im-tomu/fomu-hardware/README.md

# Tomu FPGA

An FPGA in your USB port!

## Hardware

The hardware design files are all in the [hardware/](hardware/) directory.  They were designed using KiCad 5.0.
