im-tomu/fomu-hardware/case/case_0.1.FCStd

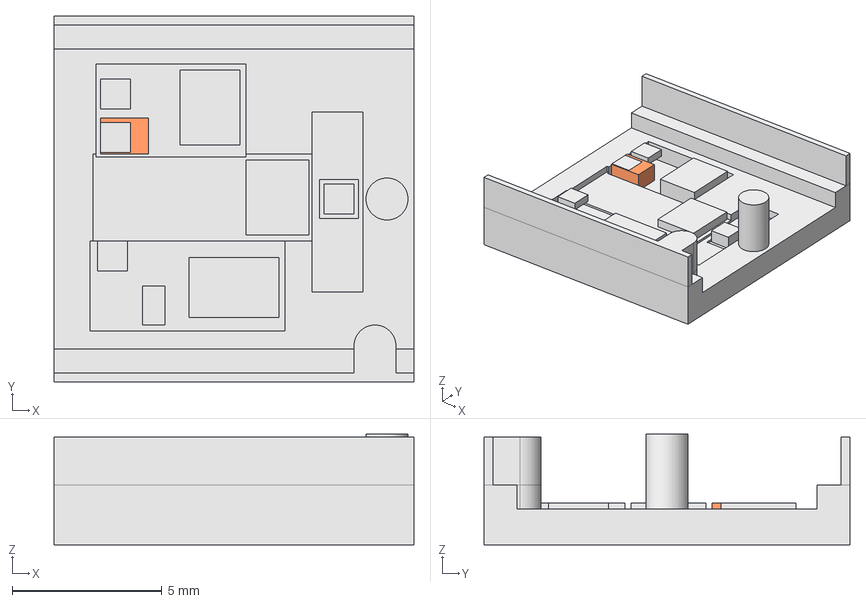
[picture p9: CAD file, 2019-07-12]
case/case_0.1.FCStd
12.0 x 12.2 x 3.70 mm
XTAL
Flash
LED
FlashCap
Hacker MEMS Pad
Regulator 1
Regulator 2
Regulator 3
ICE40
Case
