im-tomu/fomu-hardware/case/case_0.3.FCStd

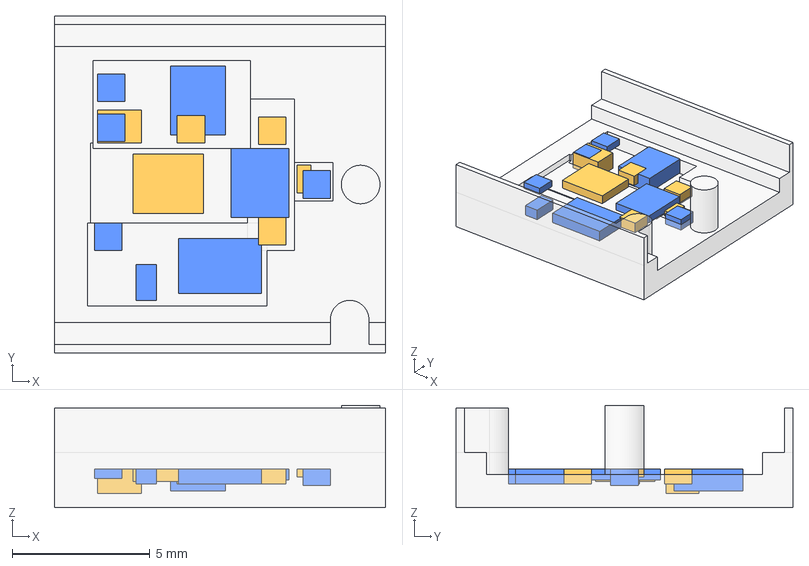
[picture p10: CAD file, 2019-07-12]
case/case_0.3.FCStd
12.0 x 12.2 x 3.70 mm
XTAL
Flash
LED
FlashCap
Hacker MEMS Pad
Regulator 1
Regulator 2
Regulator 3
ICE40
Case
Hacker LED
Hacker ICE40
Hacker Regulator 1
Hacker Regulator 2
Hacker Regulator 3
Hacker Regulator Cap
