im-tomu/fomu-hardware/case/fomu case v5.step

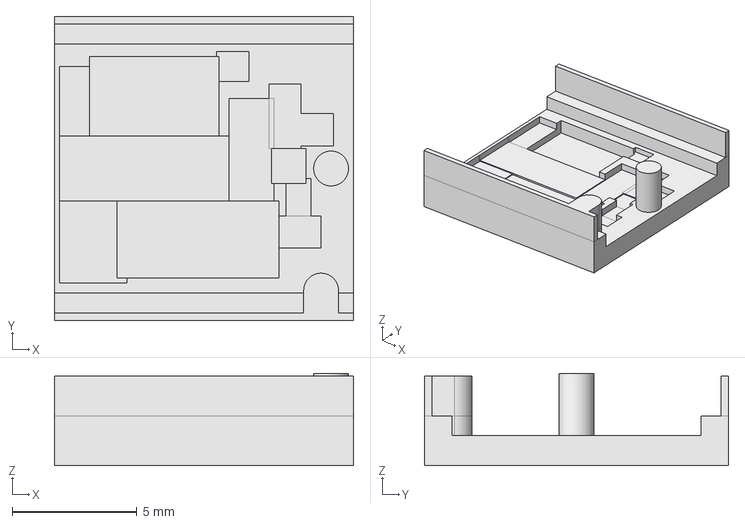
[picture p12: CAD file, 2019-07-12]
case/fomu case v5.step
12.0 x 12.2 x 3.70 mm
