im-tomu/fomu-hardware/case/case_0.2.FCStd

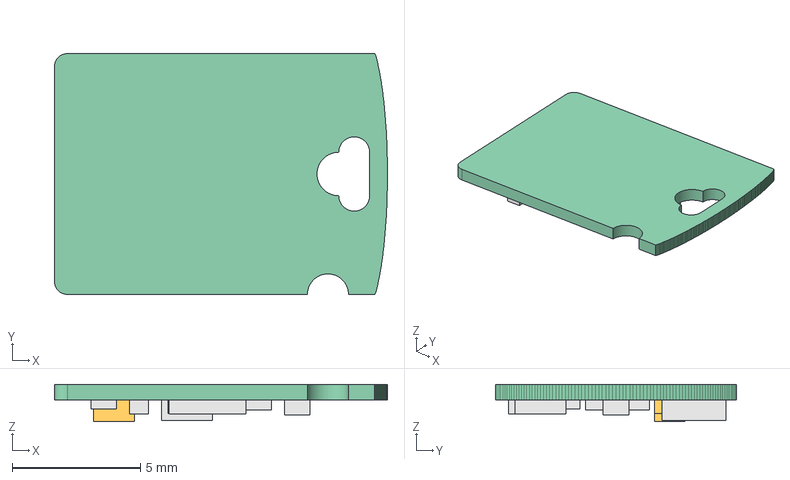
[picture p13: CAD file, 2019-07-12]
case/case_0.2.FCStd
13.0 x 9.40 x 1.45 mm
Pcb
XTAL
Flash
LED
FlashCap
Hacker MEMS Pad
Regulator 1
Regulator 2
Regulator 3
ICE40
Hacker LED
