im-tomu/fomu-hardware/archive/pvt/fomu-pvt-jig.FCStd

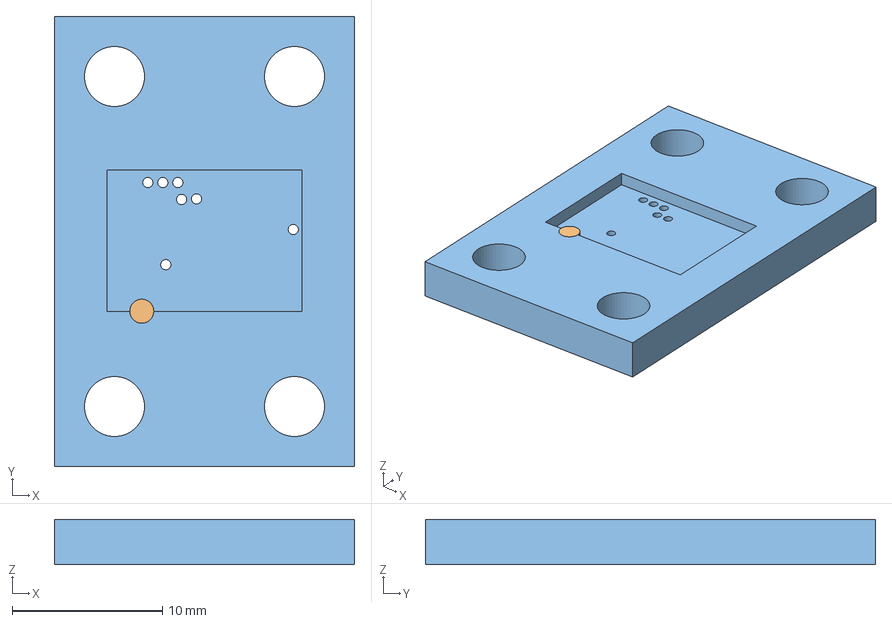
[picture p14: CAD file, 2021-11-25, an earlier design]
archive/pvt/fomu-pvt-jig.FCStd
20.0 x 30.0 x 3.00 mm
