im-tomu/fomu-hardware/(list of files, cad)

Other CAD files:
case/case_0.6.FCStd
case/case_0.5.FCStd
case/case_0.1.stl
case/case_0.2.stl
case/case_0.3.stl
case/case_0.4.stl
case/case_0.5.stl
