im-tomu/fomu-hardware/(threads)

Thread 3 (2019-01-01):

RGB LED Brightness

drandreas, 2019-01-01:
The brightness of red, green, blue is fundamentally different.

To get white the colours have to be mixed:
 - Red @ duty cycle of 1/128
 - Green @ duty cycle of 1/16
 - Blue @  duty cycle of 1/1

The code blow demonstrates the issue.

[rgb.zip](https://github.com/im-tomu/fomu-hardware/files/2719656/rgb.zip)

Edit: According to the documentation, the FPGA has a RGB LED driver with a per color configurable current. What are reasonable values?

drandreas, 2019-01-02:
Looking at the LED's data sheet the current should be <=10mA for continues operation.

I configured the LED driver as follows
 - Red @ 2mA
 - Green @ 2mA
 - Blue @ 10mA

This is clearly the way to go. However it still isn't giving a nice color mixture w/o using pwm in addition.

[rgb_pwm.zip](https://github.com/im-tomu/fomu-hardware/files/2720520/rgb_pwm.zip)

mithro, 2019-01-02:
There isn't really any space for resistors on the board :-P

mithro, 2019-01-02:
Also makes a good starting project for people :-)

drandreas, 2019-01-03:
I’ve came up with another idea.

Blue LEDs have a typical forward voltage thats higher then other colors. Cree states a average forward voltage of 2.9V in the datasheet.

The 2.5V power supply might be simply to low (value taken from schematic)?

drandreas, 2019-01-03:
Note: It could also be that my sample is perticularly bad.

xobs, 2019-01-03:
I haven't noticed this issue on my EVT boards, and those should be electrically identical to the final release.

Can you post an example verilog file to demonstrate what you're seeing? Also, does it change at all if you press on the FPGA part?

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

drandreas, 2019-01-03:
I can counter the issue by having different duty cycles for blue, green and red. I also do only intend to use the RGB LED for diagnostic purposes. So this issue is kind of solved.

However, I wanted to understand why to intensity of the colours is fundamentally different. So I kept digging. The data sheet and hacker version schematic are telling me that the blue LED might be running outside of its spec:
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

This discovery is a correction to my initial perception that RED and GREEN are too bright - BLUE is too dim. Since not much can be done about this I'm closing the issue. Never the less I'm curious why 2.5V instead of 3.3 are used as power source.

xobs, 2019-01-04:
Good find!

The hacker version uses a 2.5V source, and the EVT/DVT/production versions of the board all use 3.3V as the source.

For those PCBs, we'll want to set the constant current sink to ~4 mA for the Red, and ~8 or 10 mA for Green and Blue (running in half mode).

Closed 2019-01-03.

Thread 5 (2019-01-30):

Can flash the fomu with probes, without having the jig

giomasce, 2019-01-30:
Hi,
I managed to flash a fomu Hacker version (v0.0 is mentioned over it) without having a jig: I soldered seven little cables connecting to the Raspberry on a side and having a probe on the other. See the photos. It is not easy to get all the wires connected without the probes snapping away, but it is possible.
The documentation might mention this possibility, as I think that many users could find it easier than printing a jig. Feel free to use my photos, if you want. The ground contact can also be reached from the button pads, which are probably less crowded and easier to reach.
Thanks for this wonderful hacking gadget!
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

mithro, 2019-01-30:
That's pretty impressive! I don't think I could get probes to stay still long enough to successful flash!

mithro, 2019-01-30:
Would be more than happy to merge a pull request showing how to do this method.

giomasce, 2019-01-30:
Here it is! :-)

giomasce, 2019-01-30:
https://github.com/im-tomu/fomu-hardware/pull/6

Closed 2019-02-21.

Thread 7 (2019-05-21):

Remove lock files

mithro, 2019-05-21:
IE -> `reference/.~lock.FPGA-iCE40UP 5k Pinout.xlsx#`

xobs, 2019-05-21:
I'm not seeing that file. I think it was removed on Christmas: https://github.com/im-tomu/fomu-hardware/commit/72816ce2538f67b389f6345c9272df4dd5a1f2e5

mithro, 2019-05-21:
https://github.com/im-tomu/fomu-hardware/tree/evt3/reference

xobs, 2019-05-21:
I've deleted that tag, since that PCB was never built.  EVT3b was built instead, which swapped the pins for PMOD to put I3C on pins 3 and 4.  As part of that tag, the lock file was deleted.

https://github.com/im-tomu/fomu-hardware/tree/evt3b/reference

Closed 2019-05-21.

Thread 8 (2019-06-25):

fomu-hardware git directory/branch structure

ewenmcneill, 2019-06-25:
On 2019-06-25 on #tomu on IRC, @xobs wrote:
> I need to collapse all the branches down to one and make subdirectories. Possibly throwing away history? Or maybe keep the history in the other branches...

The easiest solution is probably to reattach each branch into its own directory in the master branch, creating a new set of git commits that mirror (but aren't the same commits) each branch.

In the past I've done that with [`git-filter-branch`](https://git-scm.com/docs/git-filter-branch)  to rewrite the branches into (or out of) a subdirectory, and then merging that rewritten branch onto master (the two branches likely have no common ancestor at that point, but git will still merge that).

If you can describe the "existing branch" to "new location on single shared branch" transformation that you want to achieve, it should be possible to turn that into an appropriate set of `git-filter-branch` commands and `git-merge` commands to achieve the result *without* throwing away the history.  (In particular "I want to push everything in this branch down one or two directory levels" is one of the easier "rewrite history" transformations...)

xobs, 2019-06-25:
The problem with that is that we would lose tags, as each release of hardware has a separate tag attached to it.  One nice property of the current approach is that you can do "git checkout evt3" and get the state of the repository when that was checked in.

ewenmcneill, 2019-06-25:
@xobs: I'm unclear on what you want here.  Do you (a) want to reassociate the tags with the new commits on the shared branch, (b) keep the old branches, or (c) not rearrange anything because it'll break some other external dependencies.

FWIW, it's perfectly possible to keep the existing branches (and their tags, if you wish), and just stop adding to them.  It's also possible to move the tags to somewhere more relevant in the new structure.  (But it's not possible to have them in both places :-) )   If the branches are re-applied on top of a central branch (`master`?) in a sensible order, the moved tags will even be fairly sensibly ordered.

Anyway my point of creating this ticket is that the mechanical part of rearranging things, retaining history is relatively simple.  Deciding what you want the new structure to look like, down to the level of "we could write a program to transform this" is complicated.

If you've decided you don't want to rearrange anything after all, because it'll break things, feel free to close this issue :-)

Ewen

ewenmcneill, 2019-06-25:
Also FWIW it's literally impossible to change anything in a `git` repository history *without* creating new commits.  By design.  Because it's a chain of hashes.  So you either live with what you have, or you make new commits.  Just saying.

Ewen

xobs, 2019-06-25:
The answer to every problem is "blockchain!"

Users will generally encounter one of three boards: EVT, PVT, and Hacker.  I'd like `master` to have a tree that looks something like:

```
+- gerber
+----- evt1
+----- hacker
+----- pvt1
+- kicad
+----- evt1
+----- hacker
+----- pvt1
+- reference
+--- schematics for boards and PDF files for components
+- case
```

Then the full history will be in the various branches.

This gives something handy to link to, in addition to making it more obvious where things are.

ewenmcneill, 2019-06-25:
What happens with `evt2` and `evt3` in that structure?  And later production versions?  Are they more parallel subdirectories?  Or are they later commits on the "evt1" directory?  Other than that question, and what happens with the tags (moved, to where; left on branch), it looks a fairly simple transformation to me.

Ewen

PS: I was trying to avoid using the "B" word :-)

xobs, 2019-06-25:
In this structure, "evt1", "evt2", etc. are all still in their respective branches, but schematics are pulled out into the `reference` directory as PDF files, and gerber files are pulled to the `gerber` directory as parallel directories.

The alternative would be to just include the zip files that I send to the production house, but that's harder to link to.

ewenmcneill, 2019-06-25:
So https://github.com/im-tomu/fomu-hardware/tree/evt/hardware/pcb becomes `kicad/evt1`?   And there's only `evt1` even though the EVT went through four revisions?  (And it's "evt1" not "evt"?)

And:

https://github.com/im-tomu/fomu-hardware/tree/evt/hardware/releases/evt1
https://github.com/im-tomu/fomu-hardware/tree/evt/hardware/releases/evt2
https://github.com/im-tomu/fomu-hardware/tree/evt/hardware/releases/evt3
https://github.com/im-tomu/fomu-hardware/tree/evt/hardware/releases/evt3b

become:

1.  `gerber/evt1`, `gerber/evt2`, `gerber/evt3`, `gerber/evt3b`; or

2.  `gerber/evt1`, `gerber/evt1`, `gerber/evt1`, `gerber/evt1` commits over the top of each other, with tags to reference which one?

If we can get to the point of a CSV file that has "existing_path,copy_to", then this is automatable, including retaining all history (in new commits) over the transformation.   But I'm still not quite clear on the transformation required.  (And we can leave the old branches just as they are, or remove them, as makes sense for each one.)

Ewen

PS: FTR, because git is a content store (ie, stored by hash of the content), having multiple copies of a given file in multiple locations / multiple branches doesn't take additional space in the git repo itself. They're all effectively symlinks.  (It only potentially takes more space on checkout  of a branch with multiple references to the same file.)

xobs, 2019-06-25:
Option (1) - the releases go into `gerber/evt1`, `gerber/evt2`, `gerber/evt3b`, etc.

With all of the schematic PDFs going either into `reference` or into `gerber` -- I'm not sure which would make more sense.

mithro, 2019-07-06:
Please take a look at https://github.com/mithro/fomu-hardware/tree/master/archive -- this is my proposal for how to structure it....

Closed 2019-07-12.

Thread 13 (2020-01-05):

Hardware Photos

gregdavill, 2020-01-05:
@mithro asked me to take some photos of the Fomu Boards.
Let me know if you would like any other angles/enclosure/LEDs lit etc.

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

mithro, 2020-01-05:
Could you do some in the case?

gregdavill, 2020-01-06:
Like these?

It is a little tricky to get the lighting good/even on both the clear case and the PCB.

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

mithro, 2020-01-06:
These all look awesome!

@gregdavill Can you add the source files in a pull request in https://github.com/im-tomu/fomu-hardware/tree/master/archive/pvt ?

Closed 2020-01-08.

Thread 17 (2020-10-12):

pvt board problems

arblake, 2020-10-12:
If I upload Rob's eforth  it reports that ttyACM0 is available. If I open a terminal program like gtkterm, the port, ttyACM0  dissappears.
If the terminal programming is running before I upload the eforth .
If Rob does the same with the hacker board he has no difficulties. He can remove the board and replace and still all works, whereas I must reload the eforth.
Any suggestions?

xobs, 2020-10-13:
eforth looks like it's overclocking the FPGA, and so it is susceptible to device variations. This means it may not work on your board.

See https://github.com/rob-ng15/Silice-Playground/issues/8

Thread 20 (2022-01-29):

Please provide fomu PVT PCB schematic PDF document.

ramkumarkoppu, 2022-01-29:
Got the fomu board, but link to board schematic https://workshop.fomu.im/en/latest/requirements/_static/reference/schematic-pvt.pdf in the workshop page is not working.

xobs, 2022-01-30:
It looks like the entirety of the `reference` directory doesn't work.

Is there something that needs to be enabled to fix symlinks during build? @mithro

ElectricPotato, 2022-09-05:
Is this schematic accurate? https://www.taricorp.net/2019/fomu-schematic.png
It seems to conflict with the PCF file from APIO's fomu/blinky example

xobs, 2022-09-06:
The workshop has been updated to point the link to the correct PDF.

Closed 2022-09-06.

Thread 21 (2022-05-04):

Hacker Fomu

slagernate, 2022-05-04:
Why not use a fully symmetric layout for the bga pads in the hacker version? This may help stability of the WLCSP.

slagernate, 2022-05-04:
NVM. Misread the gerbers. However, I do wonder if the yield issue is related to the small diameter pads used on the perimeter of the WLCSP.

Closed 2022-05-04.

Thread 22 (2022-08-12):

Question about iCE40 BGA Land Pattern

Cushychicken, 2022-08-12:
Howdy! This isn't an issue per se - I was hoping you could talk a little bit about the footprint you used for the iCE40 part in your design.

The main things I noticed:

- You've staggered the pad diameter between pads on the underside. Best as I can tell it's alternating 0.23mm and 0.2mm diameter pads.
- You're using NSMD (non soldermask defined) pads. We're using 0.25mm pads with no change in mask diameter, so effectively SMD (soldermask defined) pads.

I'm experiencing some issues on a board with the same iCE40 part - out of my initial run of 10 boards, only 1 FPGA actually worked. 😆 I've run myself ragged testing the power, reset, clock sequence, and I'm convinced that's correct. I'm also able to program the device on board, just not run any RTL. My suspicion is that the inner balls of the BGA are not making good pad contact with the board.

Wondering if your land pattern is in response to some manufacturability issues with FOMU - any context you have to offer would be greatly appreciated. Thanks a zillion!

xobs, 2022-08-12:
The difference in diameter size was due to using via-in-pad, which necessitated making some pads bigger. I made the pads symmetrical in order to prevent the part from rotating during reflow -- the theory being it's pulled equally in all directions.

I was asked by my PCB vendor  to increase those pads specifically, and we had very few manufacturability issues once we solved the hard gold issue. You're welcome to use the footprint in your projects!

Cushychicken, 2022-08-12:
I may give that footprint a shot - thanks for the recommendation.

Do you have a link to the hard gold issue you mentioned? I'd like to read up on what you were struggling with there, and see if it has anything in common with our issues.

xobs, 2022-08-12:
It was a problem during actual PCB manufacture. There was an update about this at https://www.crowdsupply.com/sutajio-kosagi/fomu/updates/fomu-production-delay

Cushychicken, 2022-08-12:
I'll read up. Thanks for your help.

Closed 2022-08-12.

Thread 24 (2023-06-13):

Attach the fomu board on WSL 2 or Virtualbox virtual machine

FelipeWcosta, 2023-06-13:
I am trying use the fomu PVT board version in a virtual machine. When I put it in USB port the Windows OS recognize it correctly, as you can see below:
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

But, when I try to attach the board to virtual machine that occur:
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

The warning is: **Unknown USB Device (Device Descriptor Request Failed)**

This erro appears in both VirtualBox and WSL 2. I updated the drivers using Zadig 2.8 and for attach the board on WSL 2 VM's I am using usbipd 3.0.0.

xobs, 2023-06-14:
There were many improvements to the reset logic in the most recent version of the firmware. Older versions, such as 1.9.1, didn't properly handle the USB reset condition and behaved like that.

Would you mind updating to 2.0.3 and see if that doesn't improve things?

FelipeWcosta, 2023-06-14:
Is there a specific command to do this? If yes, Which is it?

FelipeWcosta, 2023-06-14:
Please, disregard my last comment. Update the firmware fixed the issue!

I'm closing this issue.

Closed 2023-06-14.

Thread 25 (2023-06-20):

Kosagi FOMU pvt board acess by `/dev/tty`

FelipeWcosta, 2023-06-20:
Hello everyone!

I am working with `litex/CFU-Playground` tools and to flash a CPU like `Vexriscv` I need to acess the board by `/dev/ttyUSB0`, `/dev/ttyUSB1` or `/dev/ttyACM0` if possible.

When I run `lsusb` I can see that device is connected:
```
Bus 002 Device 001: ID 1d6b:0003 Linux Foundation 3.0 root hub
Bus 001 Device 004: ID 1209:5bf0 Generic Fomu PVT running DFU Bootloader v2.0.4
Bus 001 Device 001: ID 1d6b:0002 Linux Foundation 2.0 root hub
```
But do not exist none file like `/dev/ttyUSB0` or `/dev/ttyUSB1` then a tryed to do something like this to have acess adding the rule at `/etc/udev/rules.d/99-kosagi-fomu-pvt.rules`:
```
SUBSYSTEM=="tty", ATTRS{idVendor}=="1209", ATTRS{idProduct}=="5bf0", MODE="0664", SYMLINK+="ttyUSB0"
```

But still does not worked, I am using `Ubuntu-22.04` by `WSL 2`.

xobs, 2023-06-20:
The cpu, by default doesn't expose a serial port. It only does DFU, so you will need to upload some temporary firmware to get the functionality you need.

Wishbone-tool knows how to speak a special protocol that allows you to debug the device, though I'm not sure if it will work via wsl2. You might need to run wishbone-tool under Windows instead.

FelipeWcosta, 2023-06-21:
I made a setup  for a `wishbone-tool`, I even can flash some values at memory to controller the RGB led, like you can see,  but no more than this. Maybe, make `Ubuntu` my main OS will be more sense.
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

Closed 2023-07-09.

Thread 26 (2025-09-01):

Is it possible to use the SPI testpoints for JTAG?

snoop911, 2025-09-01:
I understand the Ice40 doesn't have a native JTAG, but since a soft-jtag is often instantiated for Lattice Reveal software, I imagine it could be done via LiteX?   Perhaps something like:

python3 -m litex_boards.targets.fomu \
  --board=fomu \
  --cpu-type=vexriscv \
  --cpu-variant=standard+debug \
  --uart-name=crossover \
  --with-jtagbone
  --csr-csv=csr.csv \
  --build

I've tried but haven't had any luck getting SpinalHDL OpenOCD (0.11.0+dev-04036-ga0220ad30) to recognize the VexRiscV:
  dtmcontrol is 0 or JTAG scan chain interrogation failed: all ones.

 ./src/openocd -c "adapter driver ftdi"
-c "ftdi vid_pid 0x0403 0x6010"
-c "ftdi channel 0"
-c "adapter speed 1000"
-c "transport select jtag"
-c 'jtag newtap lx cpu -irlen 4'
-c 'target create lx.cpu0 vexriscv -endian little -chain-position lx.cpu -dbgbase 0xF00F0000'
-c 'vexriscv cpuConfigFile cpu0.yaml'
-c 'init'
-c 'reset halt'

xobs, 2025-09-02:
You certainly could repurpose the JTAG pins that way, but doing so requires additional hardware in the form of:

1. A test jig to hit the pins
2. A hardware debugger to speak JTAG

neither of which are very common in beginner circles. Additionally, if your openocd is looking for "dmcontrol" then that's looking for a standard risc-v debug spec implementation, which isn't present on Fomu. Perhaps a newer version of the vexriscv cpu would have it, yes, but that would require more work.

snoop911, 2025-09-07:
Yes, that's the goal.  Thru the normal USB/SPI interface I want to program a bitstream design that instantiates a JTAG controller on the 4 user I/O pins.

I tacked wires on the I/Os and connected it to an OpenOcd supported jtag chip (FTDI F2232H).

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

I've checked the connection between the Fomu and the JTAG adapter, and everything is going where it should yet SpinalHDL OpenOCD does not see the VexRiscV.

```
Error: JTAG scan chain interrogation failed: all ones
Info : JTAG tap: riscv.tap tap/device found: 0x41111043 (mfg: 0x021 (Lattice Semi.), part: 0x1111, v
er: 0x4)
Error: dtmcontrol is 0. Check JTAG connectivity/board power.
Warn : target riscv.cpu examination failed
Error: Trying to use configured scan chain anyway...
Error: lx.cpu: IR capture error; saw 0x0f not 0x01
Error: ERROR: Error while reading from socket: No error
Error: Can't communicate with the CPU
Warn : target lx.cpu0 examination failed
Warn : There are no enabled taps. AUTO PROBING MIGHT NOT WORK!!
Warn : Bypassing JTAG setup events due to errors
Error: !!!
TARGET: lx.cpu0 - Not halted
```

I know by default the fomu uses the vexriscv minimal variant, but is there any reason standard+debug can't work?  Should I try instantiating a different Cpu.. NEORV32?  I'm not too familiar with LiteX or openocd so I'm sure the issue is between the keyboard and the chair... but I've hit a wall trying to figure it out what!
