im-tomu/fomu-hardware/hacker/releases/v0.0-19-g154fecc/schematic.pdf

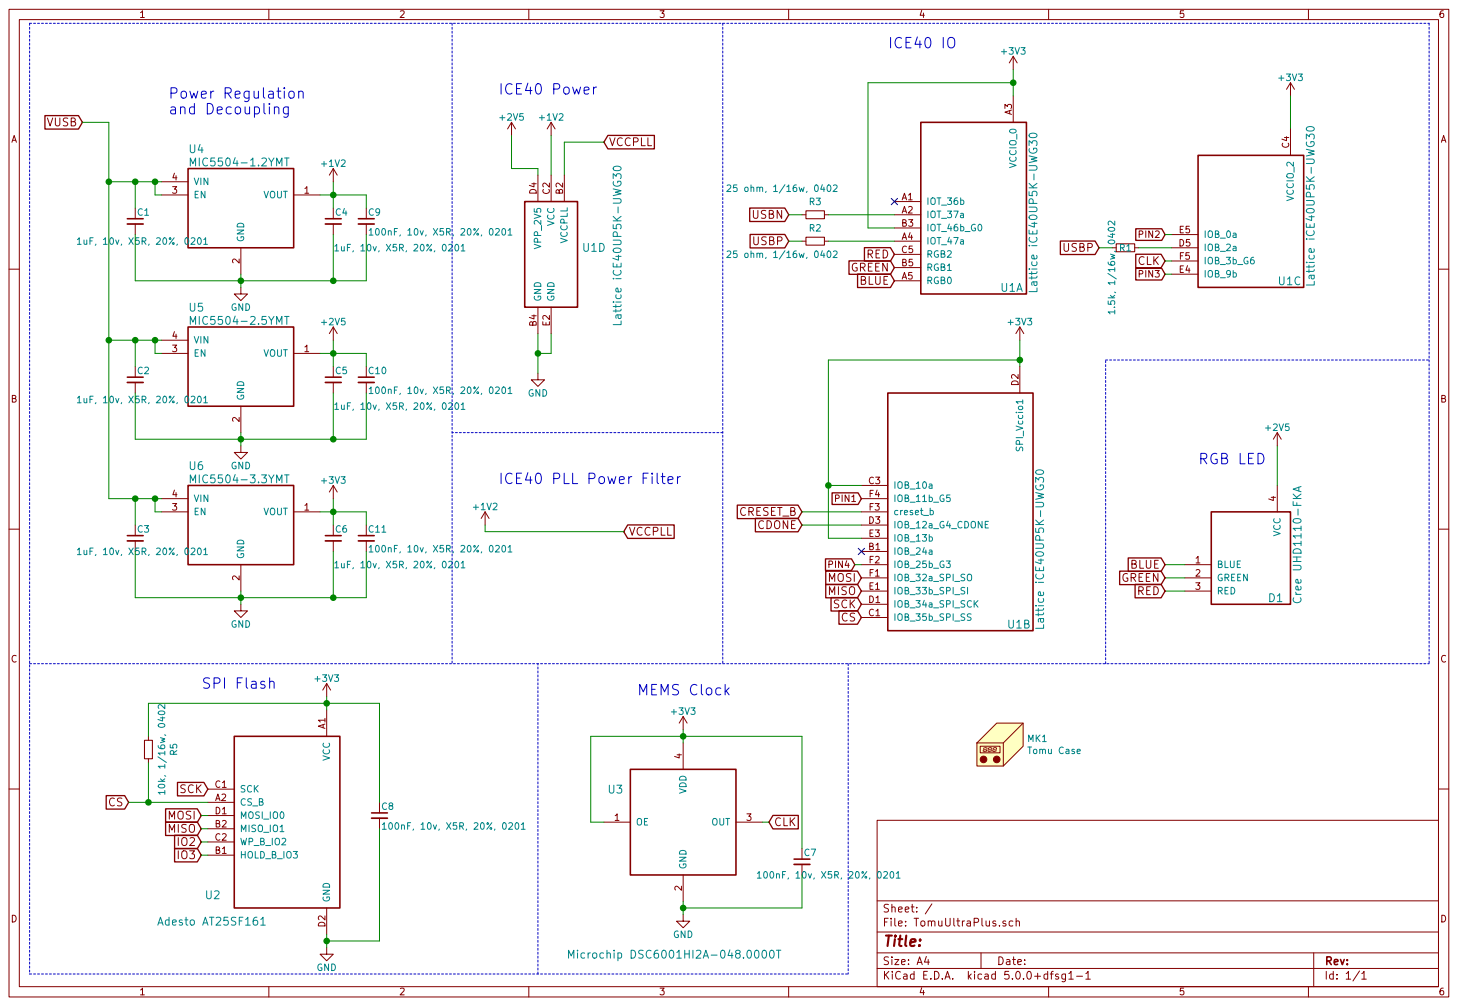
[picture p15: page 1]

4 BLUE 1 GREEN 2 RED 3 D1 Cree UHD1110-FKA VDD

MEMS Clock SPI Flash
