im-tomu/fomu-hardware/archive/dvt/releases/dvt1c/gerber/tomu-fpga-schematic.pdf

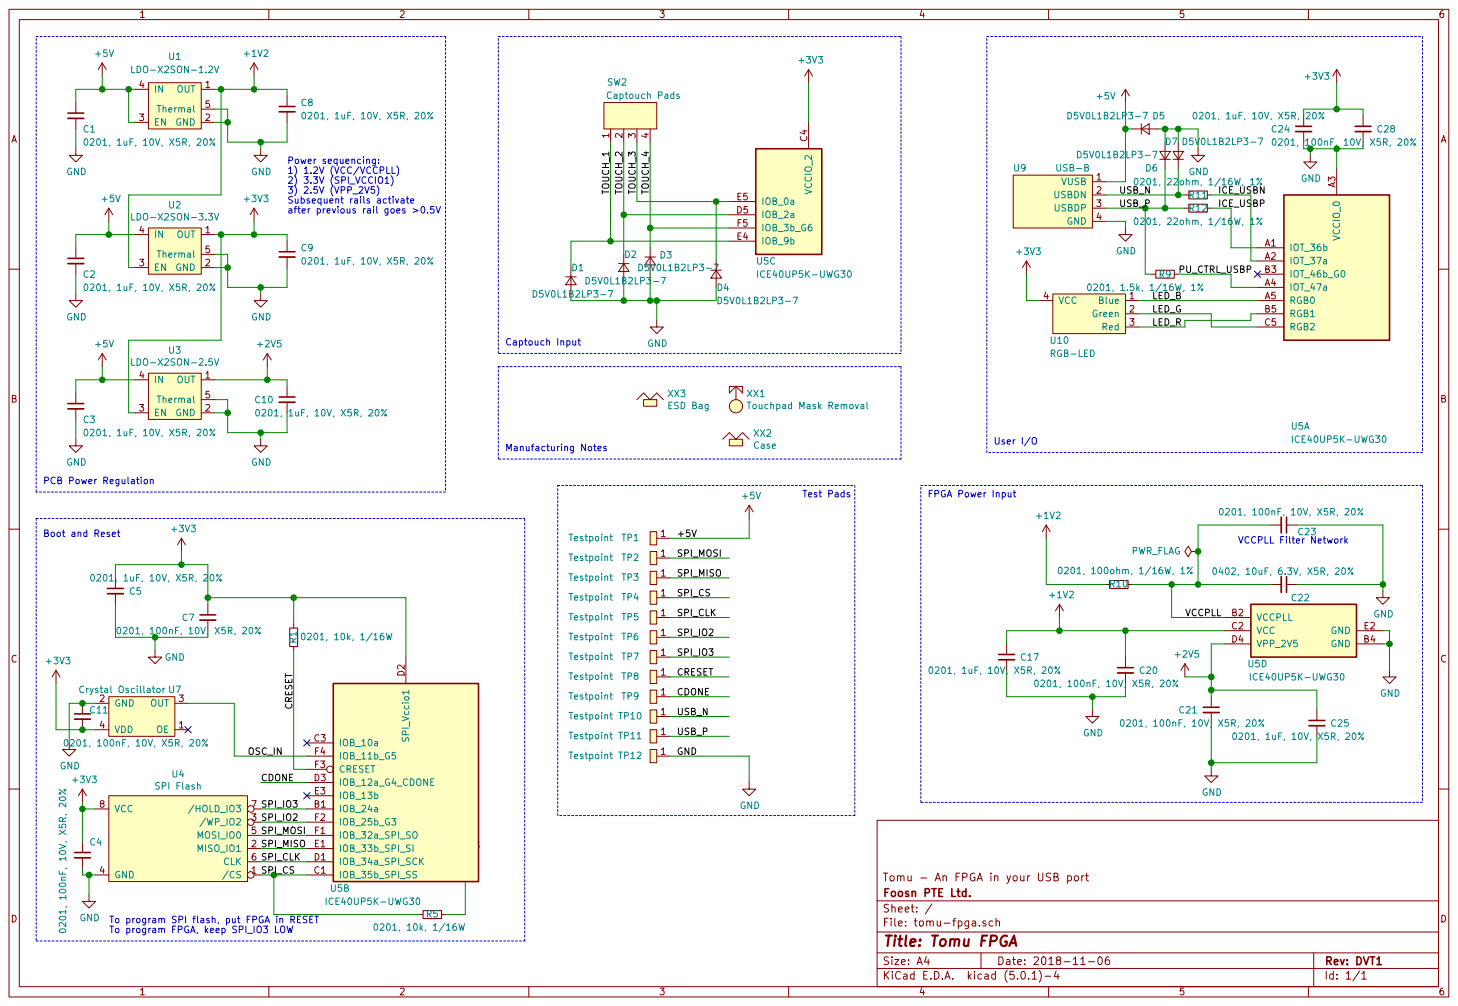
[picture p16: page 1]

File: tomu-fpga.sch Sheet: / Foosn PTE Ltd. Tomu - An FPGA in your USB port GND GND GND

ICE40UP5K-UWG30 To program SPI flash, put FPGA in RESET

Id: 1/1 Title: Tomu FPGA

To program FPGA, keep SPI_IO3 LOW
