im-tomu/fomu-hardware/archive/pvt/releases/pvt1/gerber/tomu-fpga-schematic.pdf

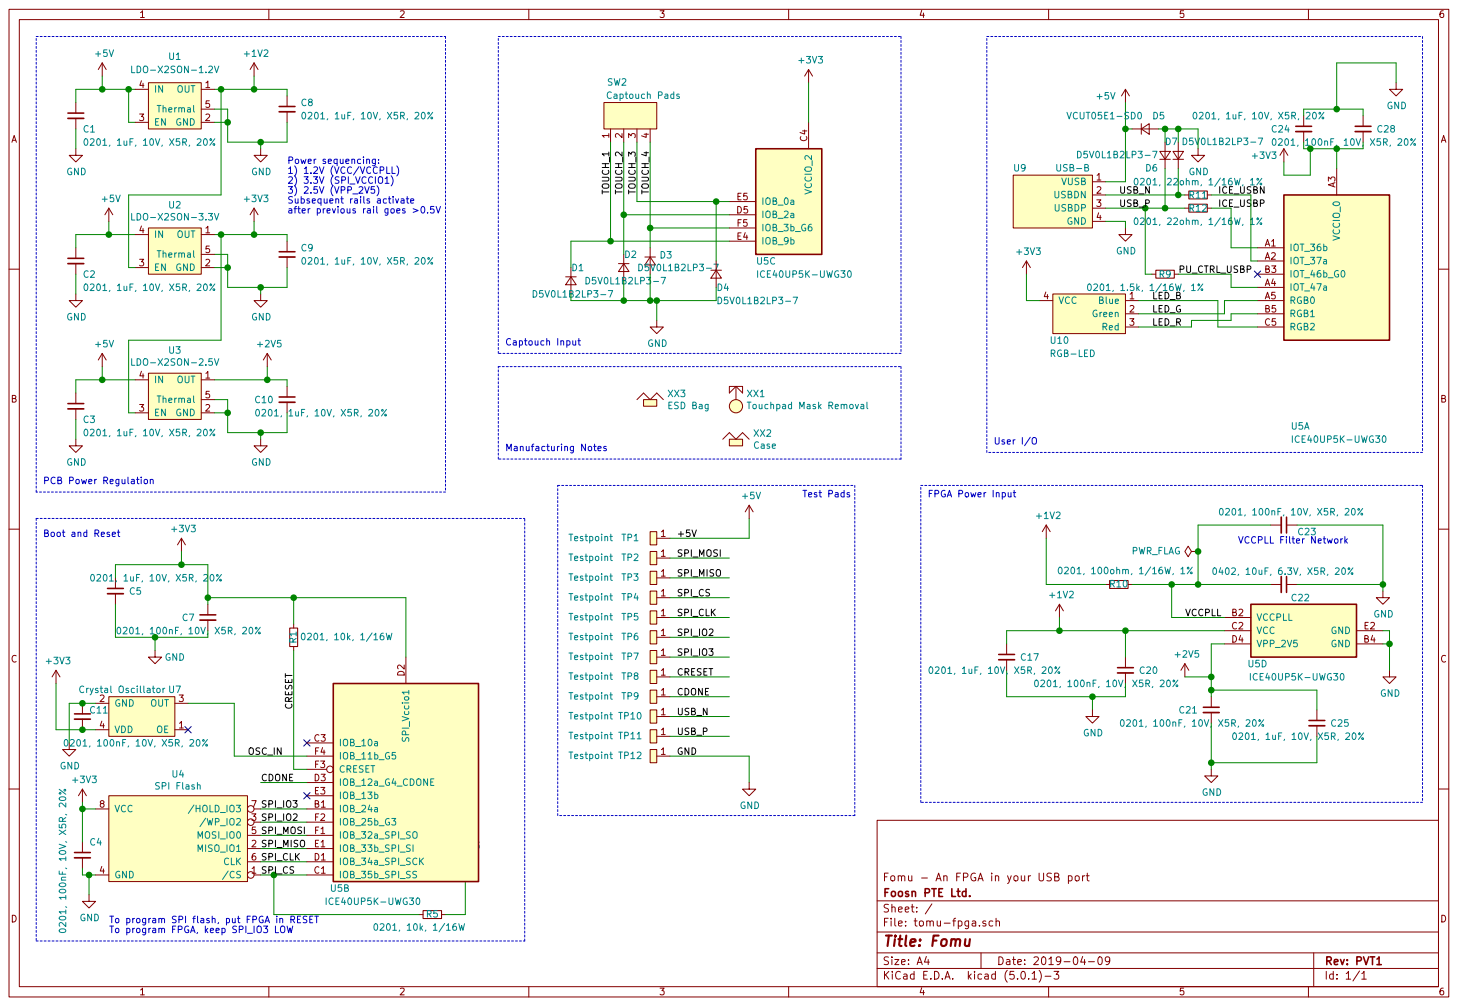
[picture p17: page 1]

File: tomu-fpga.sch Sheet: / Foosn PTE Ltd. Fomu - An FPGA in your USB port GND GND GND

IOB_2a D5

IOB_9b E4

ICE40UP5K-UWG30 To program SPI flash, put FPGA in RESET

To program FPGA, keep SPI_IO3 LOW
