im-tomu/fomu-hardware/archive/evt/releases/evt1/tomu-fpga-evt1.pdf

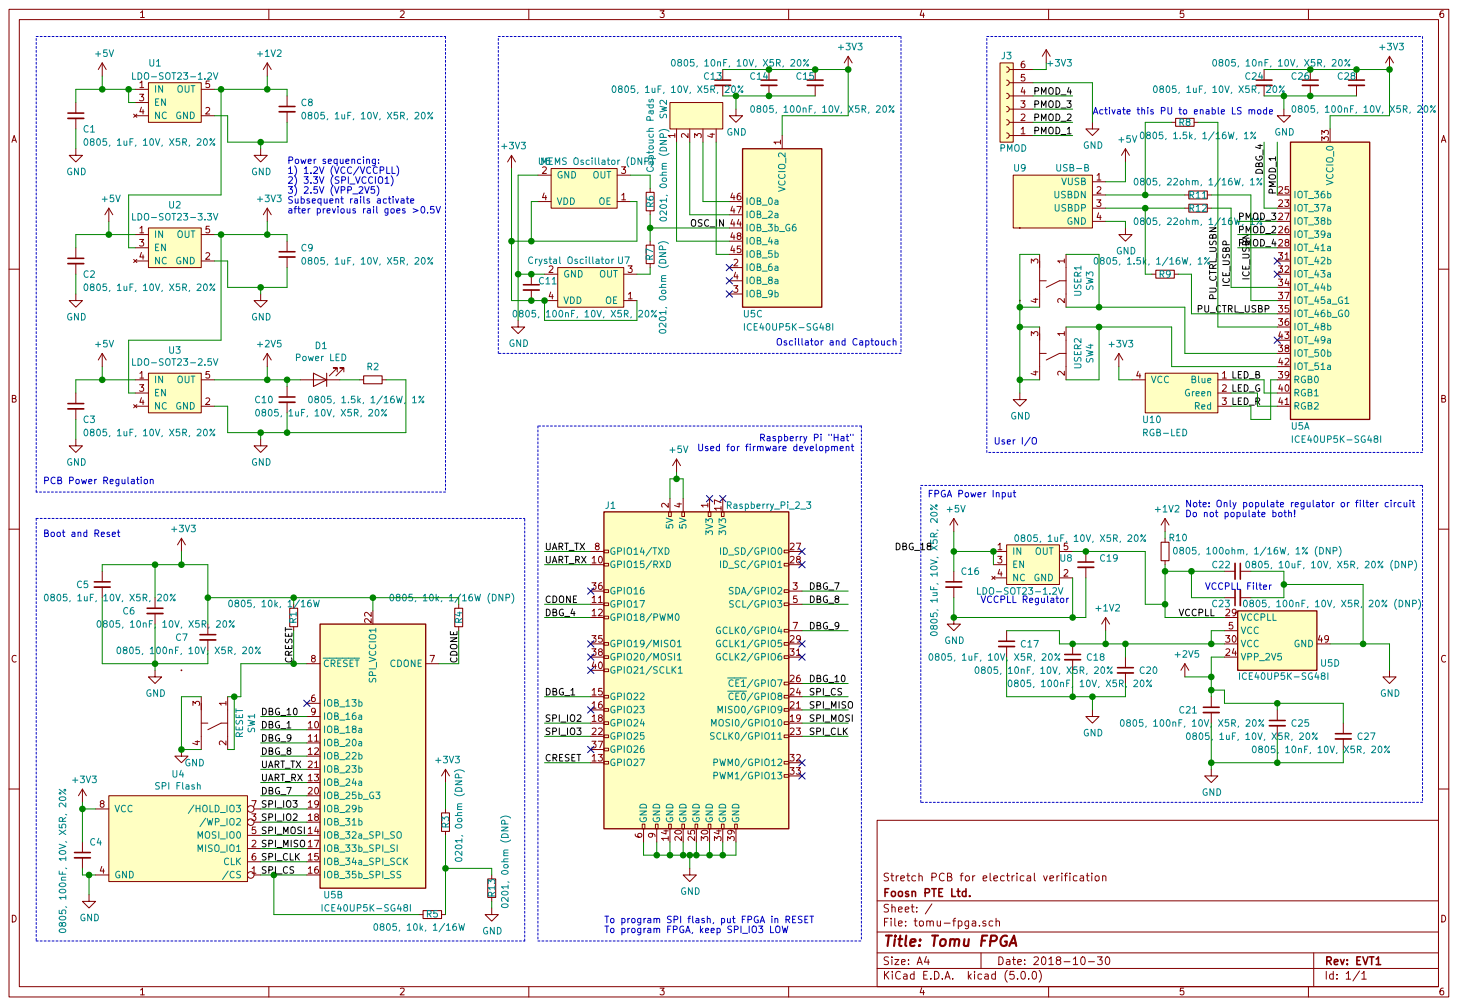
[picture p18: page 1]

Activate this PU to enable LS mode

Used for firmware development 1 2

Note: Only populate regulator or filter circuit

File: tomu-fpga.sch Sheet: / Foosn PTE Ltd. Stretch PCB for electrical verification

Id: 1/1 Title: Tomu FPGA

To program FPGA, keep SPI_IO3 LOW
