im-tomu/fomu-hardware/archive/evt/releases/evt2/gerber/tomu-fpga-evt2.pdf

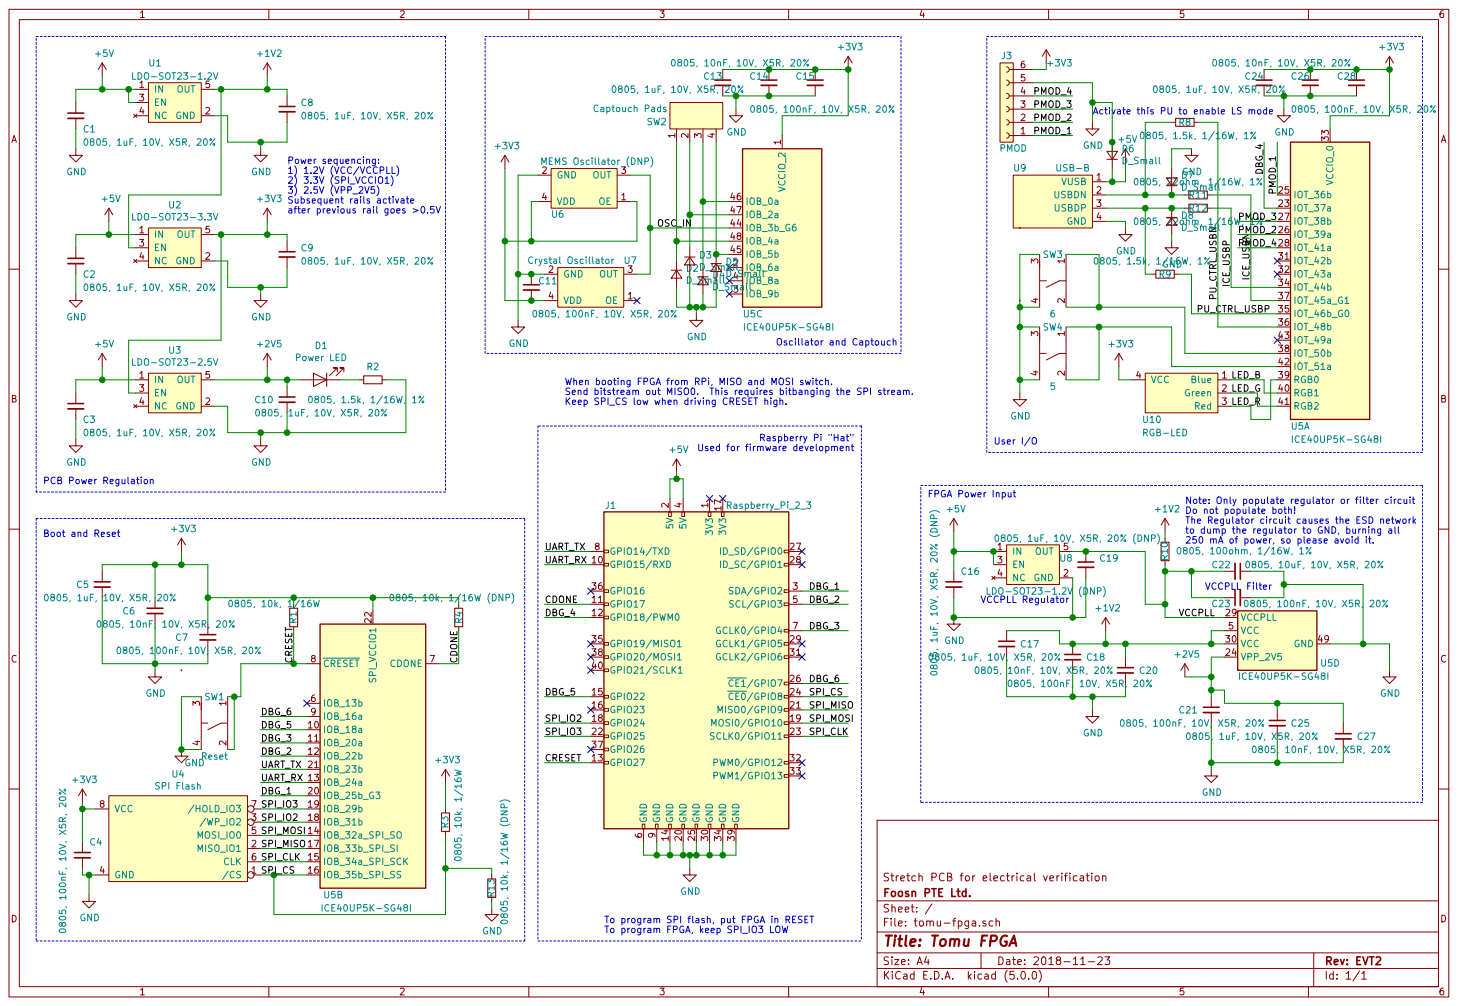
[picture p19: page 1]

Activate this PU to enable LS mode

IOB_3b_G6 44

Keep SPI_CS low when driving CRESET high. D2D_Small D3D_Small D4D_Small D5D_Small GND

IOB_5b 45

When booting FPGA from RPi, MISO and MOSI switch.
Send bitstream out MISO0. This requires bitbanging the SPI stream.

Used for firmware development 1 2

Note: Only populate regulator or filter circuit
Do not populate both!
The Regulator circuit causes the ESD network
to dump the regulator to GND, burning all

File: tomu-fpga.sch Sheet: / Foosn PTE Ltd. Stretch PCB for electrical verification

Id: 1/1 Title: Tomu FPGA

To program FPGA, keep SPI_IO3 LOW
