im-tomu/fomu-hardware/archive/dvt/releases/dvt1c/gerber/tomu-fpga_assy.pdf

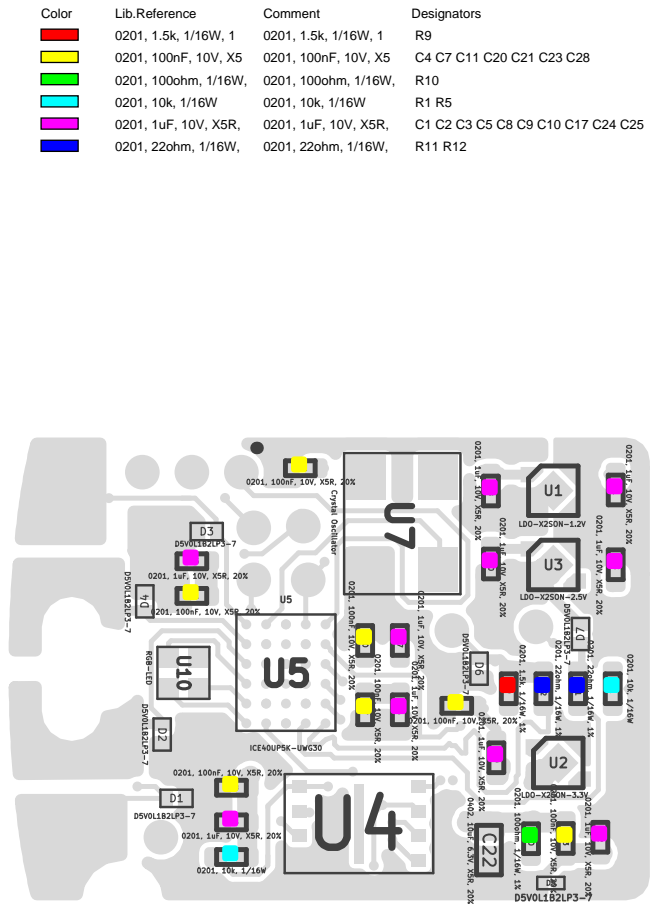
[picture p20: page 1]

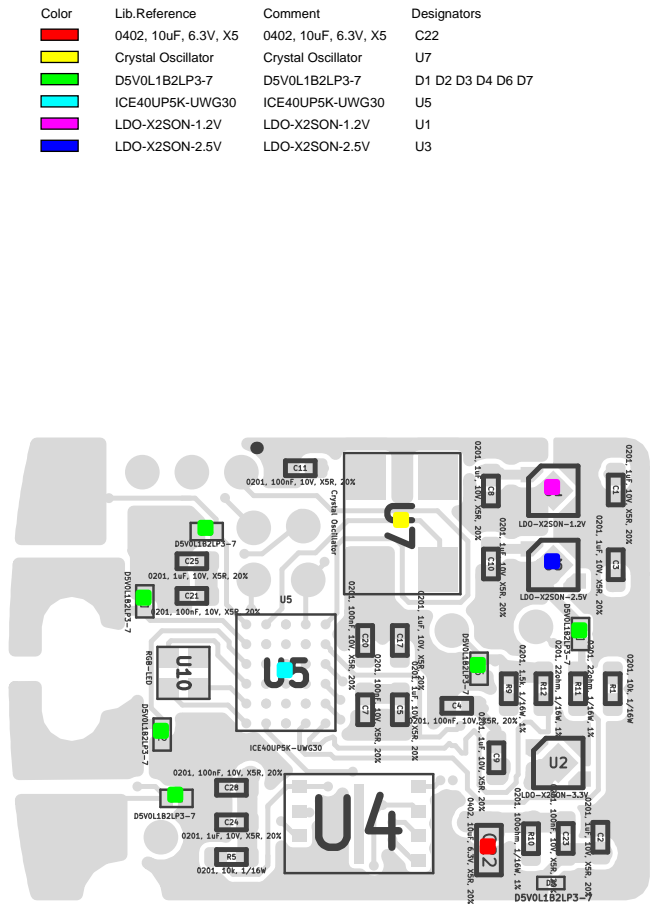
[picture p21: page 2]

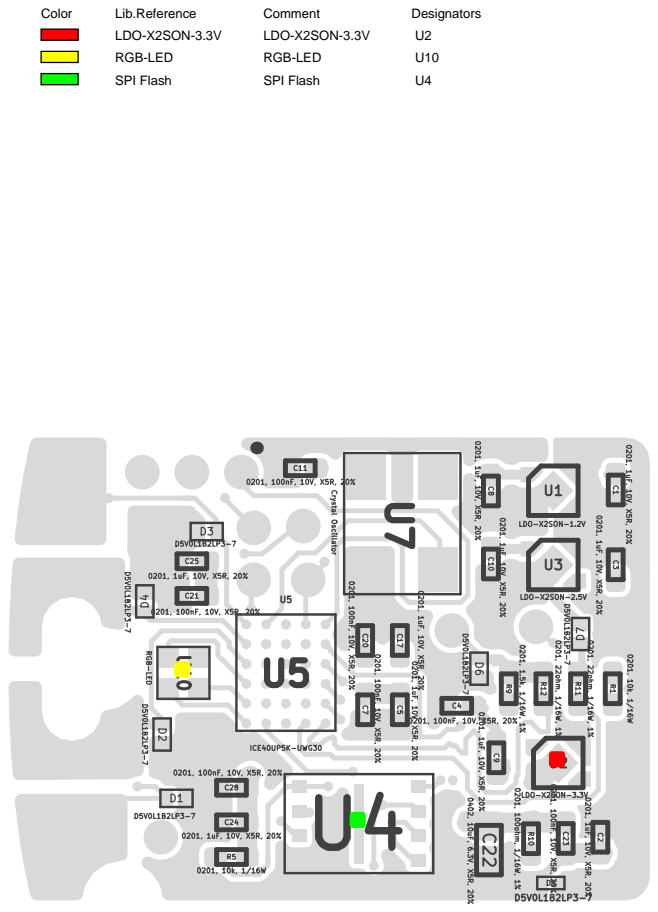
[picture p22: page 3]
Color; Lib.Reference; Comment; Designators; LDO-X2SON-3.3V; RGB-LED; SPI Flash
