im-tomu/fomu-hardware/archive/dvt/releases/dvt1e/gerber/tomu-fpga-dvt1e-assy.pdf

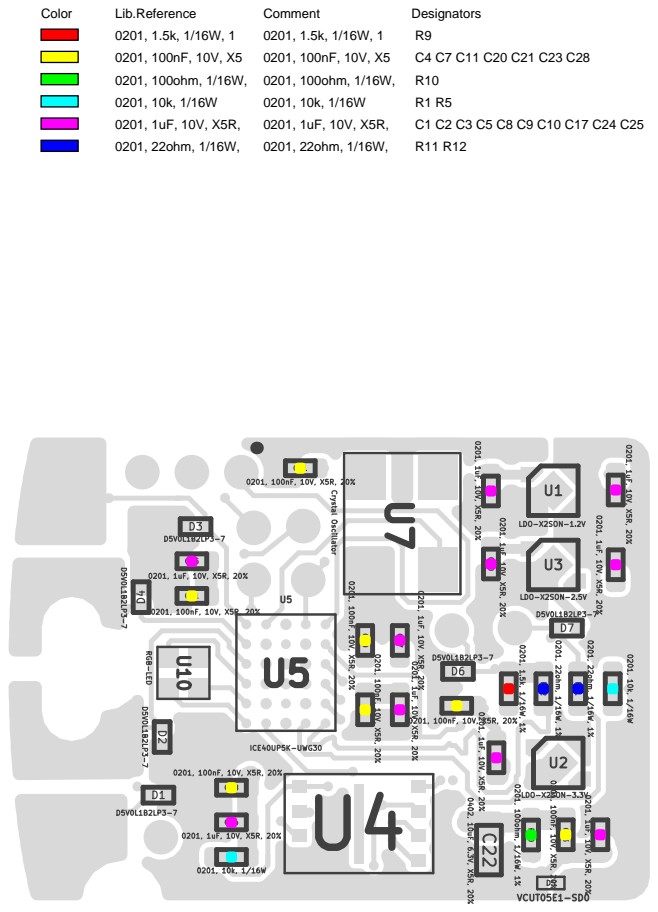
[picture p23: page 1]

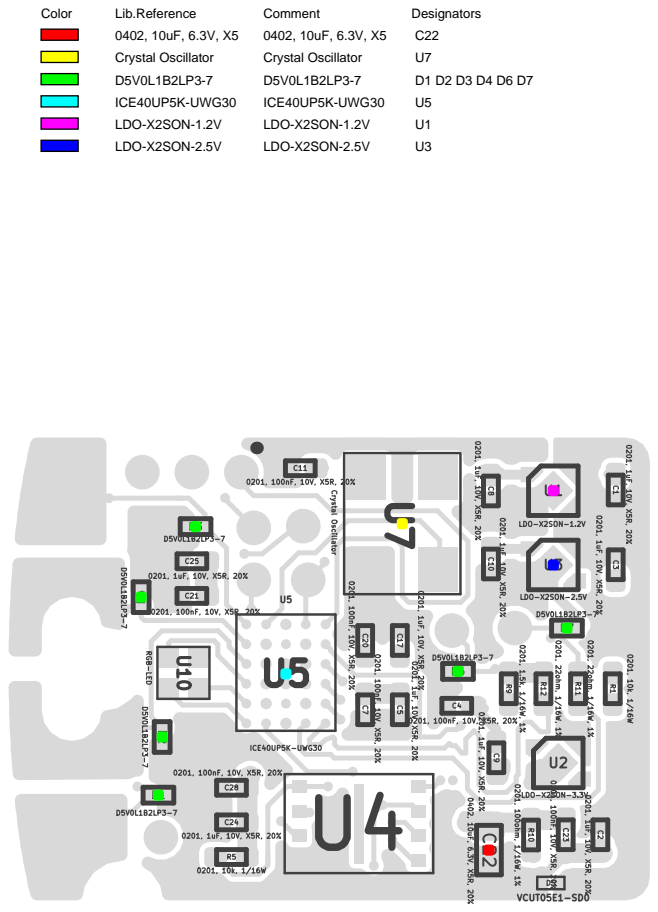
[picture p24: page 2]

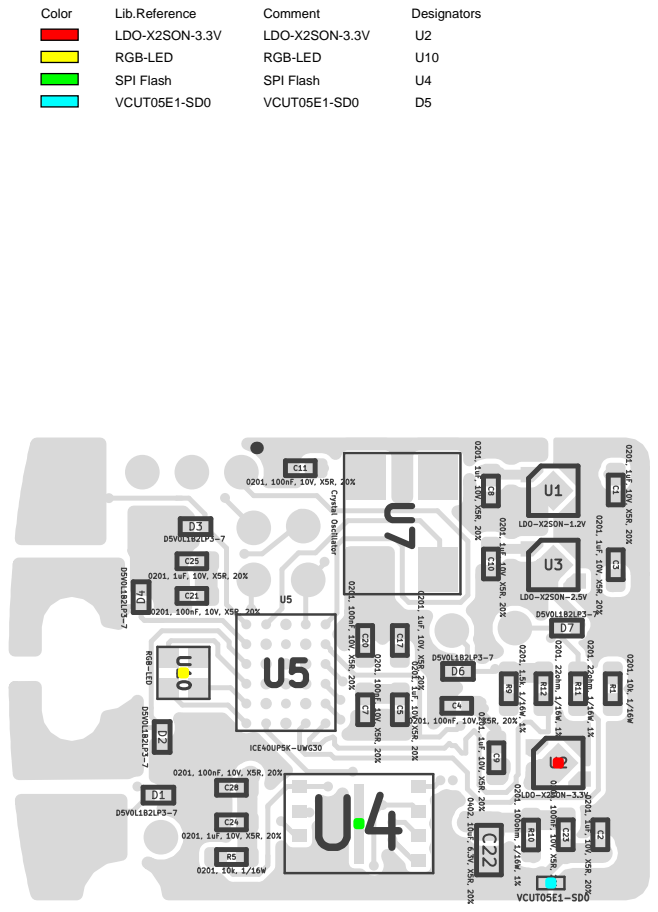
[picture p25: page 3]
Color; Lib.Reference; Comment; Designators; LDO-X2SON-3.3V; RGB-LED; SPI Flash; VCUT05E1-SD0
