im-tomu/fomu-hardware/archive/dvt/releases/dvt2a/gerber/tomu-fpga_assy.pdf

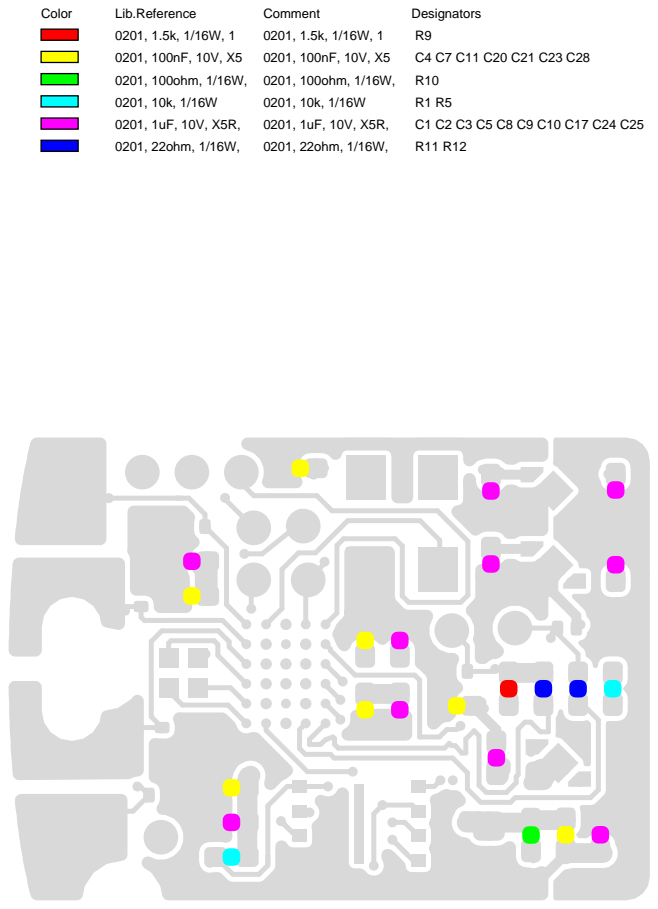
[picture p26: page 1]

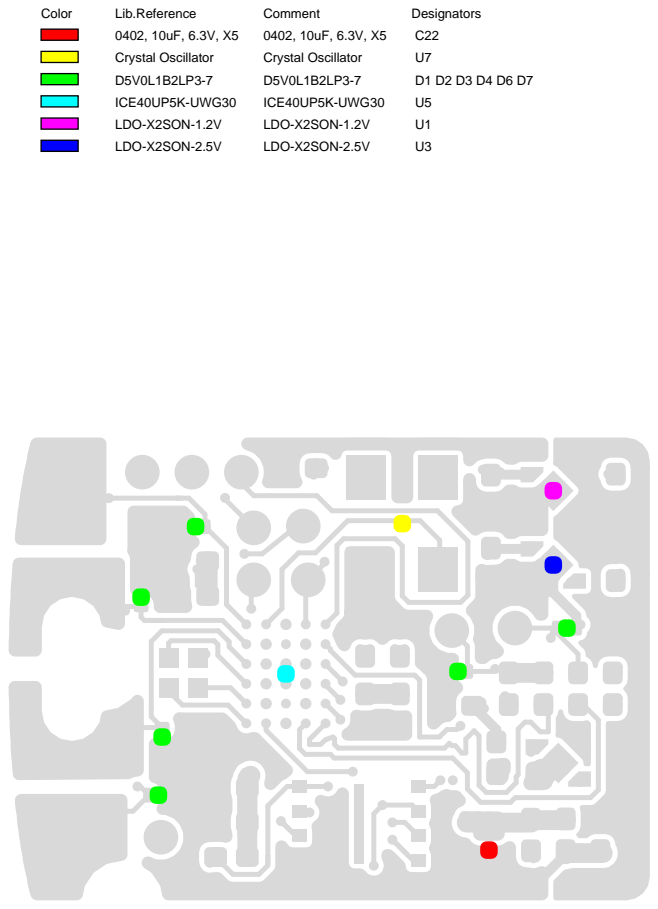
[picture p27: page 2]

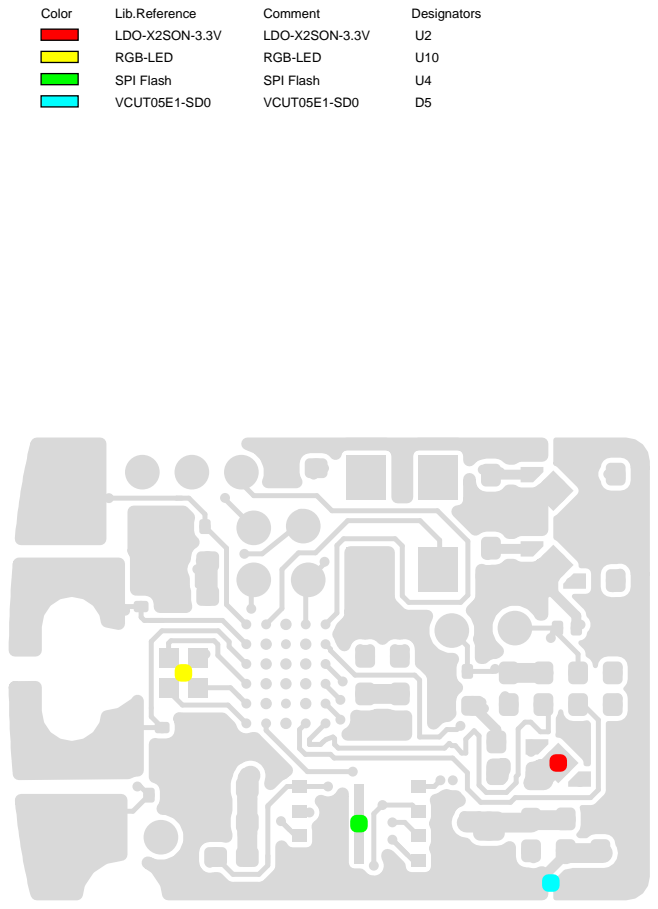
[picture p28: page 3]
Color; Lib.Reference; Comment; Designators; LDO-X2SON-3.3V; RGB-LED; SPI Flash; VCUT05E1-SD0
