im-tomu/fomu-hardware/archive/evt/releases/evt3b/gerber/tomu-fpga_assy.pdf

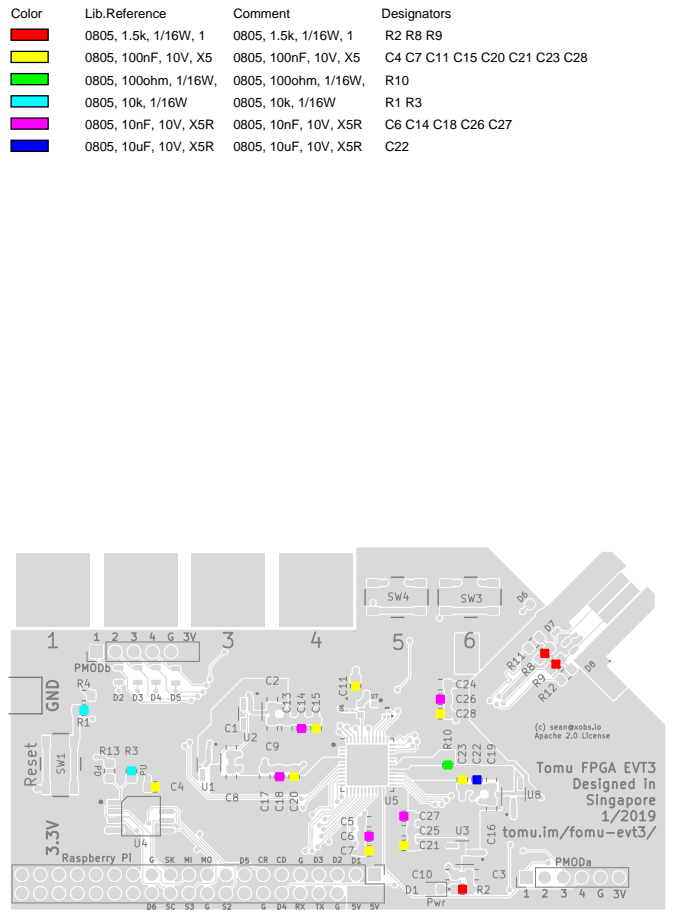
[picture p33: page 1]

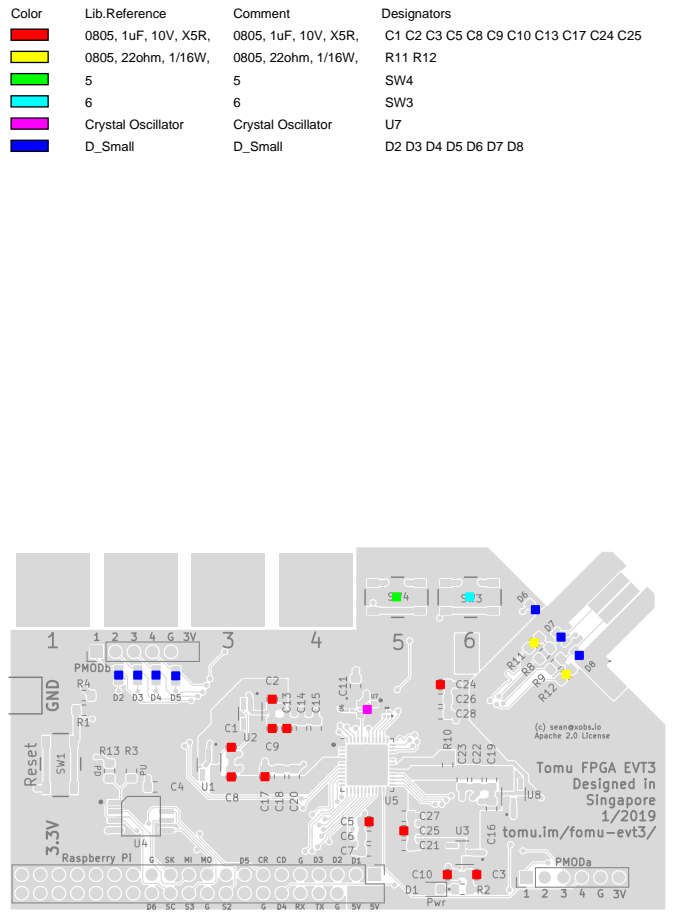
[picture p34: page 2]

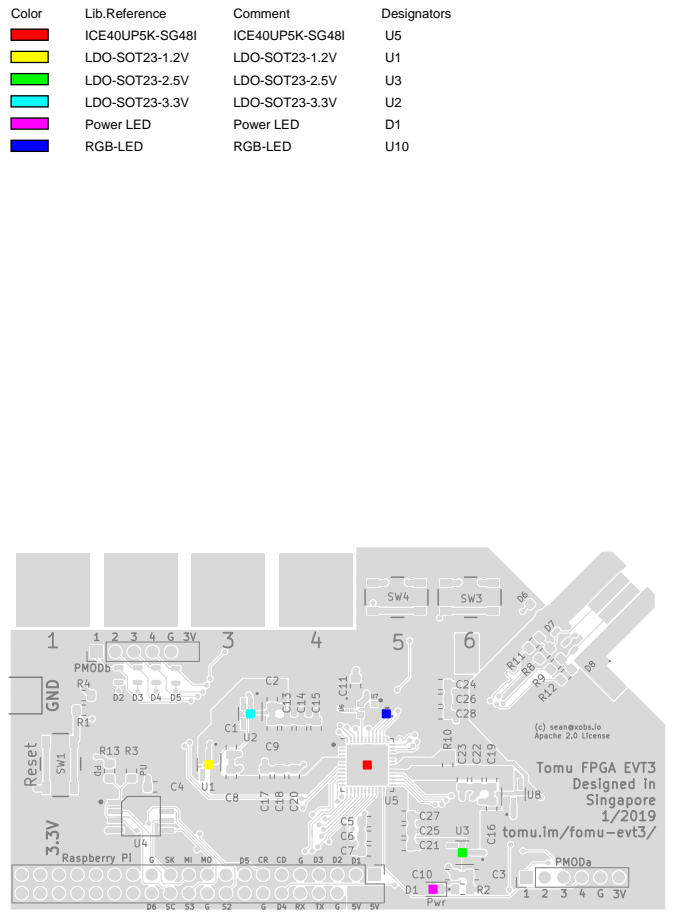
[picture p35: page 3]
Color; Lib.Reference; Comment; Designators; ICE40UP5K-SG48I; LDO-SOT23-1.2V; LDO-SOT23-2.5V; LDO-SOT23-3.3V; Power LED; RGB-LED

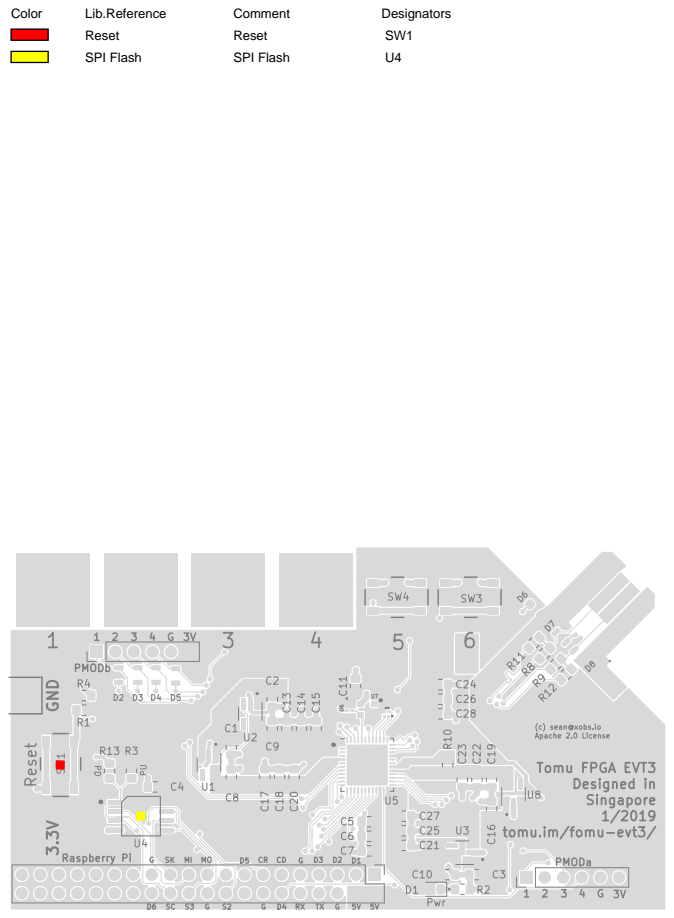
[picture p36: page 4]
Color; Lib.Reference; Comment; Designators; Reset; SPI Flash
