im-tomu/fomu-hardware/archive/pvt/releases/pvt1/tomu-fpga-pvt1.pdf

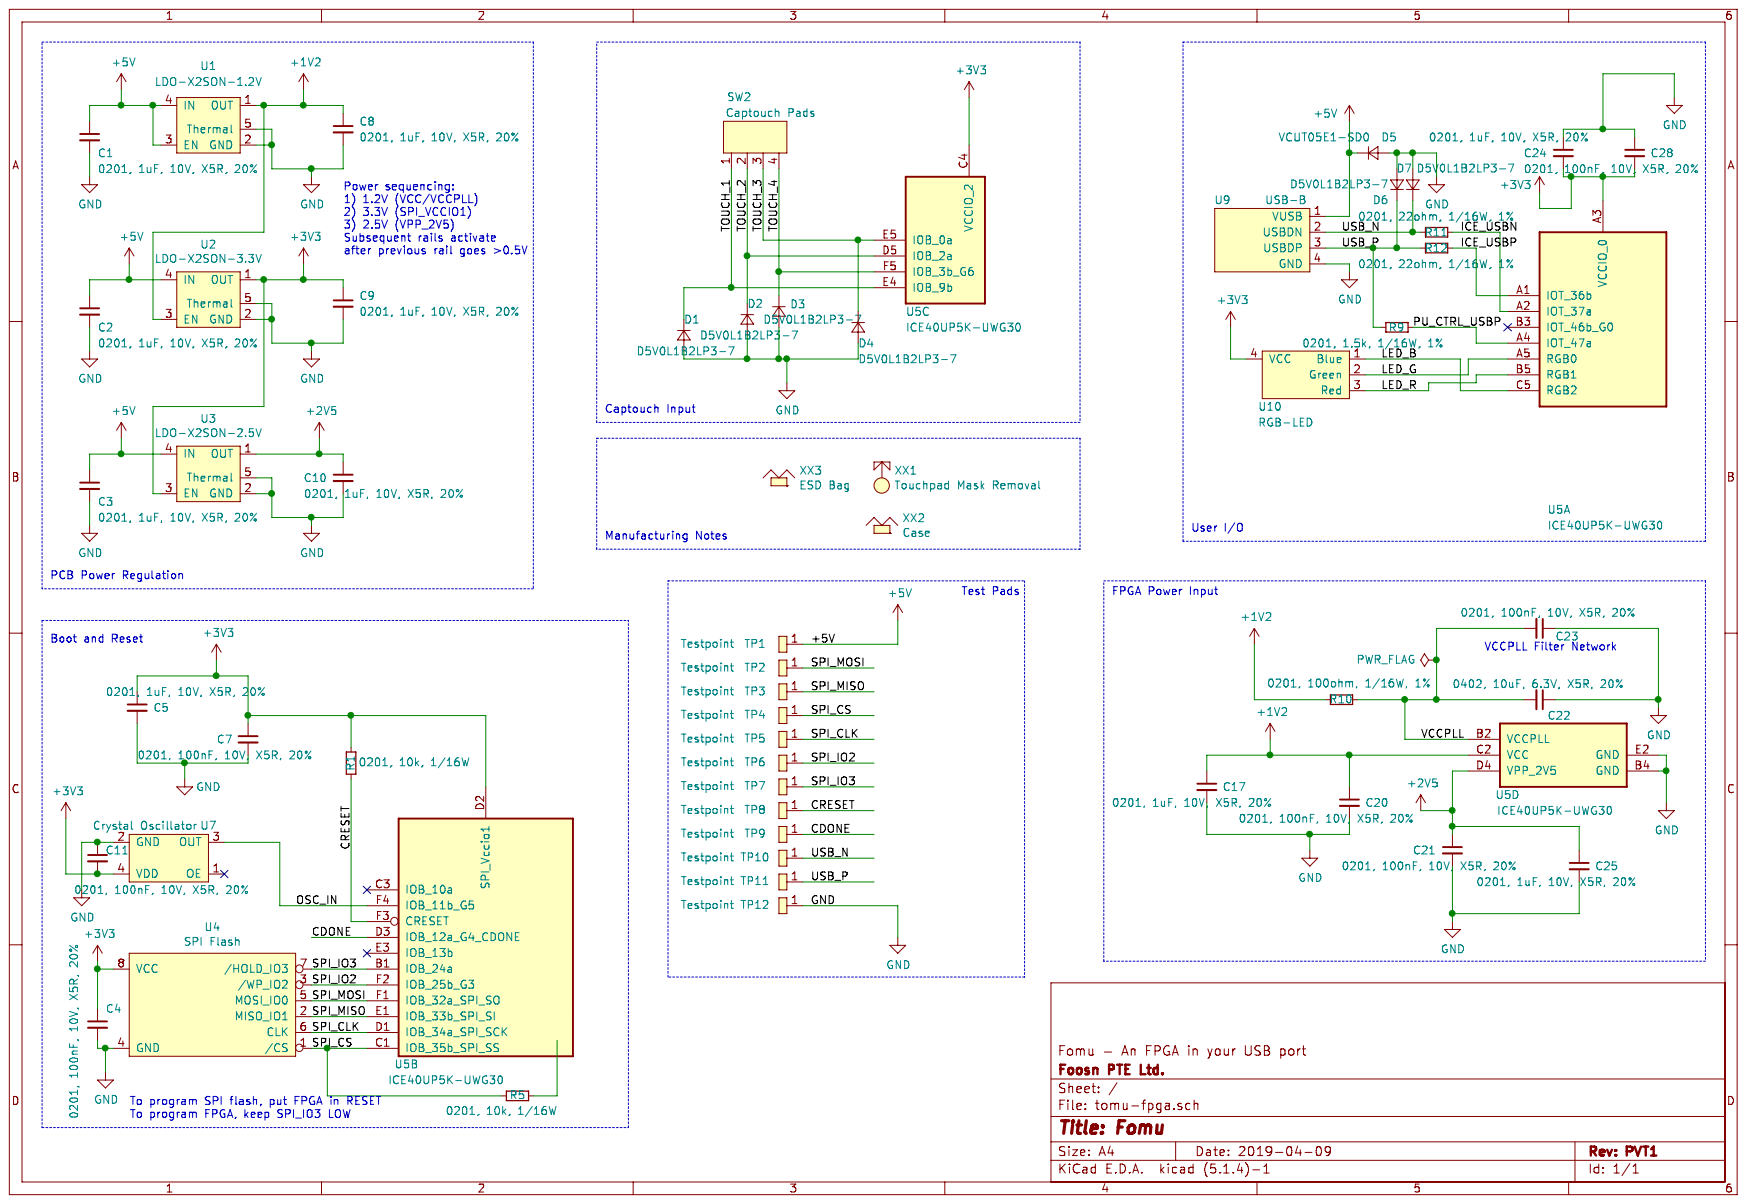
[picture p37: page 1]
