im-tomu/fomu-hardware/(commit log)

2018-10-30 initial commit
    Add work-in-progress files for Tomu ICE40 FPGA.
    [tomu-fpga.kicad_pcb, tomu-fpga.sch]
2018-10-30 reference: initial commit
    Add an initial commit of reference documentation.
    [FPGA-iCE40UP 5k Pinout.xlsx]
2018-10-30 pcb: sch: initial beta draft
    This is the first feature-complete version of the schematic.
    [tomu-fpga.sch]
2018-10-30 pcb: sch: finish evt1 schematic
    This should be a feature-complete schematic. Now to start on PCB
    layout.
    [tomu-fpga.sch]
2018-10-30 reference: evt1: add schematic
    Add a schematic for EVT1, based on the most recent design.
2018-10-30 pcb: add tomu-fpga project file
    This has changed slightly, so add the updated version.
2018-10-30 pcb: sch: add tomu-fpga-cache.lib
    This file appears to be a local version of the schematic symbols used in
    the .sch file, so add it.
2018-10-30 hardware: rename directory from `pcb`
    [tomu-fpga.kicad_pcb, tomu-fpga.sch]
2018-10-30 LICENSE: add BSD 3-clause license
    It doesn't really make sense for PCBs, which will end up licensed under
    a different scheme, but it will work for the source code that will end
    up here.
2018-10-30 hardware: pcb: add manufacturer and part numbers
    [tomu-fpga.sch]
2018-10-30 hardware: rename `tomu-fpga` to `pcb`
    This more closely reflects what it actually is.
    [tomu-fpga.kicad_pcb, tomu-fpga.sch]
2018-10-30 pcb: sch: renumber schematic
    Renumber the schematic again, as things have shifted around a bit.
    [tomu-fpga.sch]
2018-10-30 hardware: sch: specify spinor part
    SPINOR parts are largely interchangeable. Pick one.
    [tomu-fpga.sch]
2018-10-30 pcb: sch: make ICE40 VCCPLL a power input
    For some reason, this pin was listed as a `power output`, which does not
    appear to be the case. Due to this error, the DRC would fail when using
    a regulator directly connected to the pin.
    Mark this pin as a `power input` to fix this, since it's really where
    power goes into the chip.
2018-10-30 hardware: sch: add crystal, VCCPLL regulator
    Add a crystal, so we can test to make sure it works.
    Also add a second regulator dedicated to VCCPLL in an effort to
    cost-down the capacitor and large components that shouldn't be
    necessary.
    [tomu-fpga.sch]
2018-10-30 reference: update evt1 schematic
    This schematic reflects more options, including two crystals now and
    more decoupling capacitors.
    It also adds an option to power VCCPLL from a second 1.2V regulator.
2018-10-30 hardware: sch: populate SPI, /RESET pullups
    It turns out these resistors are important.
    [tomu-fpga.sch]
2018-10-30 hardware: pcb: add SPI debug header
    This will be used to program SPI during board bringup.
    [tomu-fpga.sch]
2018-10-30 reference: update evt1 schematic pdf
    This adds the `SPI Header`.
2018-10-31 reference: evt1: publish final-final-final schematic
    It's final this time! I mean it!
2018-10-31 pcb: schematic-cache: add Raspberry Pi, new SPI Flash
    This reworks the SPI Flash layout and adds the Raspberry Pi header.
2018-10-31 hardware: sch: restructure SPI Flash symbol
    It's much cleaner if we put power pins on one side and signal pins on
    the other. This removes the ratsnest that was building up.
2018-10-31 hardware: sch: use raspberry pi header, rework signaling
    Rework the signaling to send everything to a Raspberry Pi header.
    [tomu-fpga.sch]
2018-10-31 hardware: update name of SPI Flash
2018-10-31 pcb: hook up more debug wires
    We have spare pins, so run more debug wires.
    Many of these will probably get cut when doing the PCB layout.
    [tomu-fpga.sch]
2018-10-31 hardware: add testpoints for SPI programming
    This will become necessary when doing factory burning.
    [tomu-fpga.sch]
2018-10-31 hardware: add footprints for most components
    Add footprints for most of the components we'll use.
2018-10-31 hardware: sch: map remaining footprints
    Add footprints for the remaining schematic components.
    [tomu-fpga.sch]
2018-10-31 hardware: pcb: add footprint library table
    This will be used to tell pcbnew where to find footprint libraries.
2018-10-31 reference: add pushbutton, red LED
2018-10-31 pcb: add our own copies of 3d models and footprints
    The Kicad default footprints seem volatile and unreliable. Going
    between two machines that both have "Kicad 5.0.0" installed results in
    incompatibilities because KiCad has renamed their footprint libraries.
    Also, for some reason it's going to Github to get footprints instead of
    using local copies.
    Copy every model and footprint we use into a local tomu-fpga.pretty.
    This lets us ensure we can work offline, and also allows us to modify
    footprints, e.g. by adding a "Pin 1" marker.
2018-10-31 hardware: sch: use footprints from `tomu-fpga`
    Use our local copy of footprints, which are guaranteed not to change
    between Kicad versions.
    [tomu-fpga.sch]
2018-10-31 hardware: pcb: initial commit
    This is an initial commit. Still unclear of how big it will be, but
    this is a good "minimum size" estimate.
    [tomu-fpga.kicad_pcb]
2018-10-31 hardware: pcb: add initial screenshot
    It's unrouted, and will probably change, but it's an idea.
2018-10-31 hardware: first fully-routed PCB
    The PCB is terrible, and probably would have all sorts of issues. Will
    rip it up and try again tomorrow.
    [tomu-fpga.kicad_pcb, tomu-fpga.sch]
2018-11-02 hardware: footprints: extend USB-B pads, fix XTAL dot
    Fix the crystal's "Pin 1" marker.
    Extend the pads on the USB-B connector.
2018-11-02 hardware: tomu-fpga-cache: add `conn-1x6` for PMOD
    This connector is used for the PMOD, so add it to the schematic library.
2018-11-02 hardware: sch: add PMOD connector
    [tomu-fpga.sch]
2018-11-02 hardware: pcb: finish layout with new PMOD connector
    This is just about manufacturable.
    [tomu-fpga.kicad_pcb]
2018-11-02 reference: add render of evt1 board
2018-11-02 reference: add updated schematic for evt1
2018-11-02 pcb: add more silk, fatten up ground traces
    Add more silk, indicating website and other info.
    While we're at it, move some traces around to give more copper area, and
    drop some more vias to improve ground performance.
    [tomu-fpga.kicad_pcb]
2018-11-02 reference: add new render of PCB
2018-11-02 reference: add render of pcb back
    Might as well put this in there, too!
2018-11-02 hardware: pcb: update drill offset, add mfg notes
    Add a note indicating the PCB thickness and color.
    Also, move the drill origin to the lower-left corner, to aid in machine
    assembly.
    [tomu-fpga.kicad_pcb]
2018-11-02 releases: add evt1 release files
    [tomu-fpga-B.Cu.gbl, tomu-fpga-B.Mask.gbs, tomu-fpga-B.Paste.gbp, tomu-fpga-B.SilkS.gbo, tomu-fpga-Cmts.User.gbr, tomu-fpga-Edge.Cuts.gm1, tomu-fpga-F.Cu.gtl, tomu-fpga-F.Mask.gts]
2018-11-02 pcb: remove usb silk, add more 5V vias
    Add more 5V vias near the 1.2V regulator, and replace a manual trace
    with a copper pour. This will increase the amount of copper going to
    both the 3.3V and 1.2V regulators, which should improve stability.
    While we're at it, remove an errant silk artifact on the USB connector.
    [tomu-fpga.kicad_pcb]
2018-11-02 hardware: pcb: move pin headers into local repo
    Move the new PMOD pin headers from KiCad into the local repo, so that it
    no longer depends on KiCad version.
2018-11-02 hardware: pcb: add pin header to dcm file
2018-11-02 hardware: pcb: loosen up the ground plane / 5V some more
    Move some vias around to get the 5V plane more breathing room. Add a
    small pour to give more copper and stabilize the net.
    [tomu-fpga.kicad_pcb]
2018-11-02 hardware: pcb: increase USB connector size
    It was only 11.3mm before. Make it 11.7mm, and center it.
    [tomu-fpga.kicad_pcb]
2018-11-02 hardware: sch: provide APN for RGB LED
    Provide an alternate part number for the RGB LED, since the current one
    is hard to source.
    [tomu-fpga.sch]
2018-11-02 reference: add reference doc for RGB LED APN
2018-11-02 reference: rename RGB LED doc so it starts with LED-RGB
    This is to differentiate it from the normal LED.
2018-11-02 reference: add evt2 schematic
    It's almost the same as evt1.
2018-11-02 releases: evt2: tag evt2
    [tomu-fpga-B.Cu.gbl, tomu-fpga-B.Mask.gbs, tomu-fpga-B.Paste.gbp, tomu-fpga-B.SilkS.gbo, tomu-fpga-Cmts.User.gbr, tomu-fpga-Edge.Cuts.gm1, tomu-fpga-F.Cu.gtl, tomu-fpga-F.Mask.gts]
2018-11-02 hardware: fix USB footprint being mirrored
    That could have been bad.
    [tomu-fpga.sch]
2018-11-02 hardawre: footprints: reverse USB footprints
    They were copied incorrectly. Fix the footprints so the pads are no
    longer mirrored.
2018-11-02 hardware: pcb: re-route USB after flipping the footprint
    It looks kinda janky, but it's better than ripping everything up and
    starting over.
    [tomu-fpga.kicad_pcb]
2018-11-02 release: tag evt3
    This is the first release that will actually work.
    [tomu-fpga-B.Cu.gbl, tomu-fpga-B.Mask.gbs, tomu-fpga-B.Paste.gbp, tomu-fpga-B.SilkS.gbo, tomu-fpga-Cmts.User.gbr, tomu-fpga-Edge.Cuts.gm1, tomu-fpga-F.Cu.gtl, tomu-fpga-F.Mask.gts]
2018-11-03 release: evt3: add bom files
    [tomu-fpga-bom.csv]
2018-11-03 hardware: pcb: redo timestamps, because kicad
    kicad decided to redo all the timestamps. There are no other changes to
    this commit.
    [tomu-fpga.kicad_pcb]
2018-11-04 releases: remove evt1 and evt2, and rename evt3 -> evt1
    evt1 and evt2 were never produced. They also would never have worked,
    because the USB connector was drawn mirrored.
    Remove these and replace them with a single `evt1` that was actually
    produced.
    This reflects the fact that the `evt1` boards actually say "EVT1" on
    them.
    [tomu-fpga-B.Cu.gbl, tomu-fpga-B.Mask.gbs, tomu-fpga-B.Paste.gbp, tomu-fpga-B.SilkS.gbo, tomu-fpga-Cmts.User.gbr, tomu-fpga-Edge.Cuts.gm1, tomu-fpga-F.Cu.gtl, tomu-fpga-F.Mask.gts]
2018-11-04 hardware: footprints: add power regulator footprint
    Add a footprint from KiCad for the power regulator we'll use.
    It refers to a 3D file that doesn't exist, so we'll need to find that
    first.
2018-11-04 hardware: sch: first draft of dvt1
    This removes much of the support debugging stuff from evt1. Still to
    do:
    - Assign footprints
    - Figure out which PU resistor to include (if any)
    - Figure out if we need to keep the USB buffering
    - Remove extra decoupling caps
    [tomu-fpga.sch]
2018-11-05 hardware: footprints: initial commit of WLCSP models
2018-11-05 Adding initial stab at putting the WIP PCB specification into the README.
2018-11-05 hardware: footprints: add testpoint footprint
    This is from Tomu, so it's verified to be the correct size.
2018-11-05 hardware: pcb: replace pcb with usb-tomu version
    We'll use this as a starting point, to maintain the same shape and size.
    [tomu-fpga.kicad_pcb]
2018-11-05 hardware: sch: work-in-progress to go from QFN to WLCSP
    [tomu-fpga.sch]
2018-11-06 hardware: footprints: cleanup ice40 footprints
2018-11-06 hardware: sch: complete schematic layout of DVT1
    This is the first cut of a schematic layout of DVT1.
    It includes all the decoupling caps still. We'll need to see if they're
    kept around.
    [tomu-fpga.sch]
2018-11-06 hardware: pcb: first unrouted layout of dvt1
    This is just a placement test, to see if it can be laid out.
    [tomu-fpga.kicad_pcb]
2018-11-06 reference: add gd25q16c SPI ROM
2018-11-06 hardware: footprints: add new footprints
2018-11-07 hardware: schematic: rewire fpga as necessary for routing
    FPGAs are great, because if there's an alternate method that's easier to
    route -- go for it! This modifies some of the connections to ease
    routing constraints.
    [tomu-fpga.sch]
2018-11-07 hardware: pcb: first full routing of pcb
    This passes DRC and has no unconnected nets.
    [tomu-fpga.kicad_pcb]
2018-11-07 hardware: footprints: add new SON50
    This has more copper, which might make hand-soldering easier. Though
    this PCB isn't going to be hand-soldered.
2018-11-07 hardware: footprints: add local copies of 3D models
    Because these files keep moving, add local copies of all of these files.
2018-11-07 hardware: pcb: add version and update silkscreen
    [tomu-fpga.kicad_pcb]
2018-11-07 reference: add screenshot and schematic for dvt1
2018-11-08 hardware: pcb: clean up traces, widen up pours
    Rework the traces somewhat to widen up the pours and remove some of the
    bifurcation that's going on.
    [tomu-fpga.kicad_pcb]
2018-11-08 hardware: pcb: add more copper to 1.2V line
    [tomu-fpga.kicad_pcb]
2018-11-08 hardware: sch: add some spice models to passives
    Identify passives and implement the various spice models.
    [tomu-fpga.sch]
2018-11-09 hardware: pcb: remove text leftover from EFM32
    This was used to select which ARM MCU to use. It is no longer relevant.
    [tomu-fpga.kicad_pcb]
2018-11-09 hardware: pcb: more tuning of traces and pours
    Open up some more pours, and move some vias to make pours larger.
    [tomu-fpga.kicad_pcb]
2018-11-10 hardware: pcb: fix `virtual` and `smd` designation
    Some components were getting added to the BOM that shouldn't have been,
    and some were missing from the pick-and-place file.
    Update the `Placement Type` to be accurate according to assembly.
    [tomu-fpga.kicad_pcb]
2018-11-10 hardware: pcb: repour and connect wire in kicad
    The `VCCPLL` line was listed as "Not Connected" in KiCad. Reconnect it,
    even though it was already connected.
    [tomu-fpga.kicad_pcb]
2018-11-10 hardawre: pcb: remove 3D models for headers
    These are nominally DNP, so remove the 3D models to make the render more
    accurate.
    [tomu-fpga.kicad_pcb]
2018-11-10 releases: evt1: add trimmed BOM
    This BOM only includes components that are used.
    [tomu-fpga-bom.csv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]
2018-11-10 hardware: sch: change "value" for user switches
    Change the "Value" of the user switch from "USER1" and "USER2" to "5"
    and "6". This way we can use the "Value" as the silk rather than adding
    another text layer.
    [tomu-fpga.sch]
2018-11-10 hardware: pcb: replace "text" with "value" for buttons
    Previously, we used text to display the "5" and "6" designators for the
    physical buttons. Replace this with a value of "5" and "6", and remove
    the extra text.
    Additionally, display "SW??" under the switch, to make hand-assembly
    easier.
    Do the same thing for the "Reset" button.
    [tomu-fpga.kicad_pcb]
2018-11-10 hardware: misc kicad-related commits
    Update the cache file, as well as the evt1 xml source file.
2018-11-10 hardware: pcb: fill pcb
    Re-do the fill, because the last commit was done with an unpoured fill.
    [tomu-fpga.kicad_pcb]
2018-11-13 hardware: pretty: led: replace pin1 marker with silk
    It turns out that if you put pads down on the silk layer, kicad doesn't
    export them. As a result, evt1 had no pin1 marker for this LED.
2018-11-13 hardware: pretty: mems: replace pin 1 with drawing
    Replace the pin 1 pad with a drawing, so kicad will export it.
2018-11-13 hardware: pretty: led-rgb: replace pin 1 indicator with drawing
    Replace the pin 1 indicator with a drawing, so that kicad will export
    it. It was a pad before.
2018-11-13 hardware: pretty: xtal: replace pin 1 marker pad with drawing
2018-11-13 hardware: 3d: add switch model
2018-11-13 hardware: sw-spst: replace 3d model with local copy
    This is another example of a 3D model that has gotten moved, causing
    kicad to not work between versions. Use a local copy of the 3D model.
2018-11-13 hardware: lib: add rpi connector to tomu-fpga.lib
    A hedge in case this part gets renamed.
2018-11-13 hardware: sch: use local copy of 20pin header
    [tomu-fpga.sch]
2018-11-13 hardware: pretty: remove 3D model from connectors
    On this PCB, these are unpopulated.
2018-11-13 hardware: pcb: update footprints and 3d models for pin 1 marker
    Update the footprints so that the pin 1 marker is actually visible by
    using silk where possible.
    [tomu-fpga.kicad_pcb]
2018-11-15 hardware: footprint: add models for regulator, BGA
2018-11-15 hardware: pcb: update PCB to use local copies of 3D files
    [tomu-fpga.kicad_pcb]
2018-11-15 hardware: pcb: hide usb footprint silk
    [tomu-fpga.kicad_pcb]
2018-11-15 hardware: pcb: reduce ground fill, loosen up routing
    Reduce the ground fill under the IC, to prevent it from sliding around.
    This gives less copper, but it should be fine for the currents we're
    drawing.
    Loosen up the routing of the 5V plane, which involves moving some
    components around. This increases the amount of copper that goes to the
    various regulators.
    Finally, reorder the caps so that the larger ones are further from the
    IC. This is done because they have a slower response time, and so can
    be further away.
    [tomu-fpga.kicad_pcb]
2018-11-15 hardware: sch: remove excess decoupling caps
    We probably don't need 10nF, because this won't do any very-high-speed
    (>100 MHz) operations. We can think about putting them back in later,
    space permitting.
    Additionally, remove an extra bank of caps for one of the IO pads.
    We'll double-up on capacitors there, which should be alright given the
    close proximity and the fact that the only thing on that IO bank is
    captouch.
    [tomu-fpga.sch]
2018-11-15 hardware: pcb: reduce the number of capacitors
    This is an initial commit removing the excess capacitors.
    We will eventually add ESD protection ICs in the space that has been
    freed up.
    [tomu-fpga.kicad_pcb]
2018-11-16 hardware: sch: remove "-rescue" and "-tomu-fpga"
    Somehow, KiCad added these strings to the parts libraries, which
    resulted in referencing a file that didn't exist.
    Remove them.
    [tomu-fpga.sch]
2018-11-16 hardware: sch: add esd diodes
    These will be placed on the USB lines as well as the captouch lines.
    [tomu-fpga.sch]
2018-11-16 hardware: pcb: partial routing of new esd diodes
    There's still a bit more to go...
    [tomu-fpga.kicad_pcb]
2018-11-16 hardware: footprint: add footprint for esd diode
2018-11-16 hardware: pcb: finish first draft of esd routing
    [tomu-fpga.kicad_pcb]
2018-11-16 hardware: sch: define spi part numbers for dvt board
    This part is smaller. Define both the part number and an alternative
    part number.
    [tomu-fpga.sch]
2018-11-16 hardware: pcb: finish routing with esd diodes
    Finish routing the PCB with the esd diodes in place.
    [tomu-fpga.kicad_pcb]
2018-11-16 hardware: cache: commit kicad's line-ending change
    Why does it do this? No one can say.
2018-11-17 hardware: footprints: 8-uson: redo footprint from pdf
    Redo the footprint for the SPI flash chip from a recommended footprint
    provided by one of the vendors.
2018-11-17 hardware: sch: add column for "DNP"
    After discussing with one factory, this is their preferred method of
    indicating a part is "Do-Not-Populate".
    [tomu-fpga.sch]
2018-11-17 hardware: pcb: connect usb esd diodes inline first
    Move the USB ESD diodes so they connect first.
    [tomu-fpga.kicad_pcb]
2018-11-18 pcb: fix up assembly notes layers
    Resize the assembly note layers so that it's usable (in theory).
    [tomu-fpga.kicad_pcb]
2018-11-18 hardware: cache: commit kicad's line-ending changes
    I really don't know why it keeps doing this...
2018-11-18 dvt1a: tag release
    [tomu-fpga-B.CrtYd.gbr, tomu-fpga-B.Cu.gbl, tomu-fpga-B.Fab.gbr, tomu-fpga-B.Mask.gbs, tomu-fpga-B.Paste.gbp, tomu-fpga-B.SilkS.gbo, tomu-fpga-Cmts.User.gbr, tomu-fpga-Edge.Cuts.gm1]
2018-11-18 hardware: pcb: increase under-fpga keepout area size
    Increase the size of the keepout area in order to remove some extra
    copper that was appearing around one of the ground pads.
    [tomu-fpga.kicad_pcb]
2018-11-18 hardware: releases: re-release dvt1a
    This adds a keepout area around the ground plane underneath the IC, to
    try and prevent it from migrating during reflow.
    [tomu-fpga-B.CrtYd.gbr, tomu-fpga-B.Cu.gbl, tomu-fpga-B.Fab.gbr, tomu-fpga-B.Mask.gbs, tomu-fpga-B.Paste.gbp, tomu-fpga-B.SilkS.gbo, tomu-fpga-Cmts.User.gbr, tomu-fpga-Edge.Cuts.gm1]
2018-11-18 hardware: pcb: re-tune differential pair
    [tomu-fpga.kicad_pcb]
2018-11-18 hardware: release: re-release dvt1a
    This tunes the differential pair.
    [tomu-fpga-B.CrtYd.gbr, tomu-fpga-B.Cu.gbl, tomu-fpga-B.Fab.gbr, tomu-fpga-B.Mask.gbs, tomu-fpga-B.Paste.gbp, tomu-fpga-B.SilkS.gbo, tomu-fpga-Cmts.User.gbr, tomu-fpga-Edge.Cuts.gm1]
2018-11-18 reference: add extra spi flash documents
    Add reference manual for the alternate spi flash chip.
2018-11-19 hardware: footprints: xtal: correct pad orientation
    The footprint was backwards, which lead to some serious performance
    issues.
2018-11-19 hardware: footprints: fix SOIC-8
    This footprint was completely incorrect. The footprint appears to be
    for a SON-8 not a SOIC-8.
2018-11-20 pcb: rework pcb with correct footprints, add tvs diodes
    Add TVS diodes, so we make sure they work.
    Also, rework the PCB so that the clock actually functions now.
    [tomu-fpga.kicad_pcb, tomu-fpga.sch]
2018-11-20 hardware: footprints: fix XTAL footprint
    The previous footprint was super super broken.
2018-11-20 hardware: footprint: add footprint for 11V TVS diode
2018-11-20 hardware: releases: re-release dvt1a
    The previous version was very broken. This also redoes some Gerber
    files so that maybe they can be opened by the factory?
    [tomu-fpga-B.CrtYd.gbr, tomu-fpga-B.Cu.gbl, tomu-fpga-B.Fab.gbr, tomu-fpga-B.Mask.gbs, tomu-fpga-B.Paste.gbp, tomu-fpga-B.SilkS.gbo, tomu-fpga-Cmts.User.gbr, tomu-fpga-Edge.Cuts.gm1]
2018-11-20 hardware: schematic: modify USB 5V TVS
    Previously, we would end up shorting power to ground all the time
    because the diodes were right on the marginal edge.
    [tomu-fpga.sch]
2018-11-20 hardware: pcb: redo xtal footprint, 12V diode
    Redo the xtal footprint, which was just flat out wrong.
    Also, replace the +5V TVS diode with one that can handle more than 5V,
    so it's not always shorting out.
    [tomu-fpga.kicad_pcb]
2018-11-20 hardware: cache: commit new cache of symbols
    Kicad regenerates this file based on what library symbols it uses.
2018-11-20 hardware: releases: re-release dvt1a
    Some duplicate files made it in, which were not very useful.
    [tomu-fpga-B.CrtYd.gbr, tomu-fpga-B.Cu.gbl, tomu-fpga-B.Fab.gbr, tomu-fpga-B.Mask.gbs, tomu-fpga-B.Paste.gbp, tomu-fpga-B.SilkS.gbo, tomu-fpga-Cmts.User.gbr, tomu-fpga-Edge.Cuts.gm1]
2018-11-20 hardware: pcb: change `gerber attributes` flag
    This should be disabled, for maximum compatibility.
    [tomu-fpga.kicad_pcb]
2018-11-21 reference: add 12V ESD reference
2018-11-23 sch: mark VCCPLL regulator as DNP, use filter circuit
    The VCCPLL line is extraordinarily sensitive to voltage rise times, and
    appears to cause the FPGA to go into latchup very very easily.
    As a result, the VCCPLL regulator burns all 250 mA of its budget
    constantly, as the FPGA shunts VCCPLL to GND. This would be ideal
    during an ESD event, but not ideal during normal operations.
    Indicate the VCCPLL Regulator approach is DNP, and that the VCCPLL
    Filter Network is preferred. Mostly because the regulator doesn't work
    at all.
    [tomu-fpga.sch]
2018-11-23 hardware: sch: update designation to EVT2
    [tomu-fpga.sch]
2018-11-23 reference: add schematic of evt2
2018-11-23 hardware: sch: re-number DBG pins to be consecutive
    Since there are only 6 pins, it doesn't make sense to have numbers such
    as "DBG_10" and "DBG_9" anymore.
    [tomu-fpga.sch]
2018-11-23 reference: re-plot evt2 schematic with new numbering scheme
2018-11-23 hardware: pcb: redo dbg numbering and add silk to rpi header
    Redo the numbering for the dbg pins. While we're at it, add some silk
    to the Raspberry Pi header so that we know what we're looking at.
    [tomu-fpga.kicad_pcb]
2018-11-23 hardware: pcb: commit evt2 version of pcb
    [tomu-fpga.kicad_pcb]
2018-11-23 hardware: footprints: add model for 5V TVM diode
2018-11-23 releases: evt2: commit evt2 release of PCB
    This fixes the XTAL footprint, the SPI FLASH footprint, and depopulates
    the VCCPLL Regulator in favor of the VCCPLL Filter Network.
    [tomu-fpga-B.Cu.gbl, tomu-fpga-B.Mask.gbs, tomu-fpga-B.Paste.gbp, tomu-fpga-B.SilkS.gbo, tomu-fpga-Cmts.User.gbr, tomu-fpga-Edge.Cuts.gm1, tomu-fpga-F.Cu.gtl, tomu-fpga-F.Mask.gts]
2018-11-24 hardware: replace VCCPLL regulator with RC network
    Having a full regulator on VCCPLL causes the ESD network in the ICE40 to
    freak out, dumping VCCPLL into GND and trying very hard to burn out the
    regulator.
    Replace it with a simple RC filter network, which is less clean but
    results in a happier ESD network.
    [tomu-fpga.kicad_pcb, tomu-fpga.sch]
2018-11-24 pcb: redo evt2 with "pin 1" dots as circles
    Redo the "pin 1" dots so they are circle graphcs and not pads, which
    don't seem to render in most Gerber files.
    [tomu-fpga-B.Cu.gbl, tomu-fpga-B.Mask.gbs, tomu-fpga-B.Paste.gbp, tomu-fpga-B.SilkS.gbo, tomu-fpga-Cmts.User.gbr, tomu-fpga-Edge.Cuts.gm1, tomu-fpga-F.Cu.gtl, tomu-fpga-F.Mask.gts]
2018-11-24 pcb: no changes
    This appears to be kicad deciding to rewrite the whole file for no
    particular reason.
    [tomu-fpga.kicad_pcb]
2018-11-24 hardware: footprints: make smt components "SMT"
    Mark these components as "SMT" rather than "through-hole", which causes
    them to be included in the pick-and-place file.
2018-11-24 hardware: pcb: update footprint SMT flags for diodes
    [tomu-fpga.kicad_pcb]
2018-11-24 releases: regenerate evt2 with proper bom file
    [tomu-fpga-top-pos.csv]
2018-11-24 releases: evt2: regenerate file after marking "virtual" components
    [tomu-fpga-B.Cu.gbl, tomu-fpga-B.Mask.gbs, tomu-fpga-B.Paste.gbp, tomu-fpga-B.SilkS.gbo, tomu-fpga-Cmts.User.gbr, tomu-fpga-Edge.Cuts.gm1, tomu-fpga-F.Cu.gtl, tomu-fpga-F.Mask.gts]
2018-11-24 hardware: footprints: mark various things as virtual
2018-11-29 hardware: releases: evt2: update "DNP" columns
    We weren't marking every DNP column correctly.
    [tomu-fpga-bom.csv]
2018-11-29 hardware: sch: fix up DNP columns
    Mark parts as DNP with an "X" in the "DNP" column.
    [tomu-fpga.kicad_pcb, tomu-fpga.sch]
2018-11-30 hardware: footprints: fix smd/virtual designation
2018-11-30 hardware: footprint: make "nothing" through-hole
    By making it through-hole, it won't show up in the pick-and-place file,
    but it will show up in the BOM list.
2018-11-30 hardware: pcb: minor modifications, update footprints
    [tomu-fpga.kicad_pcb]
2018-11-30 releases: tag dvt1b
    [tomu-fpga-B.CrtYd.gbr, tomu-fpga-B.Cu.gbl, tomu-fpga-B.Fab.gbr, tomu-fpga-B.Mask.gbs, tomu-fpga-B.Paste.gbp, tomu-fpga-B.SilkS.gbo, tomu-fpga-Cmts.User.gbr, tomu-fpga-Edge.Cuts.gm1]
2018-12-11 hardware: footprints: fix up Fab layer for all modules
    Modify the `fab` layer so that it defaults to having footprint
    identifiers, and places the designators in an area that makes sense.
2018-12-11 hardware: pcb: fix drill origin, Fab layer
    Fix up the Fab layer so that it is actually useful now.
    Additionally, move the drill origin so that it is in a sane place.
    [tomu-fpga.kicad_pcb]
2018-12-11 hardware: releases: add dvt1c
    This fixes up the fab layer, and adds an assembly document.
    [tomu-fpga-B.CrtYd.gbr, tomu-fpga-B.Cu.gbl, tomu-fpga-B.Fab.gbr, tomu-fpga-B.Mask.gbs, tomu-fpga-B.Paste.gbp, tomu-fpga-B.SilkS.gbo, tomu-fpga-Cmts.User.gbr, tomu-fpga-Edge.Cuts.gm1]
2018-12-15 pcb: move "11 cm" tag out from behind PCB
    [tomu-fpga.kicad_pcb]
2018-12-22 hardware: footprints: enlarge some pads on ICE40
    Enlarge some pads, to allow the PCB house to stay within tolerances.
    They say that pads must be 0.23mm to ensure the laser doesn't escape the
    pad.
2018-12-22 hardware: pcb: make soldermask actually function
    The default kicad rules are dumb, and almost caused this PCB to be made
    wrongly.
    Fix the soldermask so that it actually works at our resolutions.
    [tomu-fpga.kicad_pcb]
2018-12-22 hardware: pcb: add assymetric pads for WLCSP
    This incorporates requests made by the PCB vendor.
    [tomu-fpga.kicad_pcb]
2018-12-22 release: add dvt1d
    This fixes the soldermask problem from Kicad.
    [tomu-fpga-B.CrtYd.gbr, tomu-fpga-B.Cu.gbl, tomu-fpga-B.Fab.gbr, tomu-fpga-B.Mask.gbs, tomu-fpga-B.Paste.gbp, tomu-fpga-B.SilkS.gbo, tomu-fpga-Cmts.User.gbr, tomu-fpga-Edge.Cuts.gm1]
2018-12-24 pcb: eco001: swap R3/R13 designators
    They were crossed somehow.
    [tomu-fpga.kicad_pcb]
2018-12-24 footprints: increase copper area for TVS diodes
    We only had the bare minimum of copper, which didn't leave a lot of room
    for the pick-and-place machine to err. Increase the footprint size for
    the TVS diodes.
2018-12-24 pcb: increase pad size for TVS diodes
    The pad size was sized exactly, which would result in assembly
    errors for the TVS diodes. Add some margin to the pad size.
    [tomu-fpga.kicad_pcb]
2018-12-24 footprints: set TVS diode as SMD
    It always defaults to through-hole for some reason.
2018-12-24 footprints: actually update footprints from datasheets
    I found the datasheets and their recommended footprints. Update them
    accordingly.
2018-12-24 sch: update part number for VBUS TVS
    It was listed as a part number from Diodes, Inc. The MPN and
    Manufacturer were correct, but the schematic part number was wrong.
    [tomu-fpga.sch]
2018-12-24 pcb: use newly-defined footprints for TVS diodes
    This uses the footprint recommendation from the manufacturer.
    [tomu-fpga.kicad_pcb]
2018-12-24 footprints: led: replace silk pad with circle
    Replace the previous silk "pad" with an actual circle. Many tools don't
    cope well with pads on the silk layer.
2018-12-24 pcb: fix drc violations with new TVS pads
    With the new TVS pad sizes, fix some DRC violations and move some stuff
    around slightly.
    [tomu-fpga.kicad_pcb]
2018-12-24 footprints: captouch: remove solder paste from captouch pads
    There really shouldn't be any paste there.
2018-12-24 pcb: remove paste from pads, change board version
    Change the board version to "dvt1e".
    Remove solder paste from the pads.
    [tomu-fpga.kicad_pcb]
2018-12-24 releases: tag dvt1e
    This fixes a bunch of minor issues, mostly with TVS diodes.
    [tomu-fpga-B.CrtYd.gbr, tomu-fpga-B.Cu.gbl, tomu-fpga-B.Fab.gbr, tomu-fpga-B.Mask.gbs, tomu-fpga-B.Paste.gbp, tomu-fpga-Edge.Cuts.gm1, tomu-fpga-F.CrtYd.gbr, tomu-fpga-F.Cu.gtl]
2018-12-24 sch: ECO004: add PMODb, swap PMODa_1 and DAT4
    Swap PMODa_1 and DAT4 so that PMODa gets two I3C-capable pins.
    [tomu-fpga.sch]
2018-12-24 pcb: ECO002 / ECO004: update pcb with second pmod, swap dat4
    [tomu-fpga.kicad_pcb]
2018-12-24 pcb: ECO003: don't put copper or solder mask on USB underside
    Leave bare FR4 on the underside of the USB connector, so there isn't
    anything to scrape off.
    [tomu-fpga.kicad_pcb]
2018-12-24 pcb: widen up gnd near usb connector
    Make the gnd pour a little bit wider near the USB connector.
    [tomu-fpga.kicad_pcb]
2018-12-24 pcb: fatten up some traces, mark silk url as evt3
    [tomu-fpga.kicad_pcb]
2018-12-25 evt3: add screenshots and schematic to reference
2018-12-25 hardware: sch: update text to read "evt3"
    [tomu-fpga.sch]
2018-12-25 hardware: pcb: update rpi header name
    [tomu-fpga.kicad_pcb]
2018-12-25 releases: tag evt3
    [tomu-fpga-B.Cu.gbl, tomu-fpga-B.Mask.gbs, tomu-fpga-B.Paste.gbp, tomu-fpga-B.SilkS.gbo, tomu-fpga-Cmts.User.gbr, tomu-fpga-Edge.Cuts.gm1, tomu-fpga-F.Cu.gtl, tomu-fpga-F.Mask.gts]
2018-12-25 sch: change name to "Fomu"
    [tomu-fpga.sch]
2018-12-29 releases: evt3b: swap i2c pins
    [tomu-fpga-B.Cu.gbl, tomu-fpga-B.Mask.gbs, tomu-fpga-B.Paste.gbp, tomu-fpga-B.SilkS.gbo, tomu-fpga-Cmts.User.gbr, tomu-fpga-Edge.Cuts.gm1, tomu-fpga-F.Cu.gtl, tomu-fpga-F.Mask.gts]
2018-12-29 hardware: sch: move i2c pins to pmoda pins 3 and 4
    The PMOD standard generally puts I2C pins on pins 3 and 4 of a PMOD
    header.
    [tomu-fpga.sch]
2018-12-29 hardware: pcb: re-layout PCB with I2C pins swapped
    Swap PMOD pins 1-2 and 3-4.
    [tomu-fpga.kicad_pcb]
2019-01-12 resize board image
2019-01-12 move programming jig to under board details
2019-01-16 hardware: rework layout and link to dvt/evt boards
    This redoes a lot of the layout. Furthermore, it distinguishes between
    evt and dvt.
2019-03-22 pcb: 3d: update hight for XTAL
    The crystal is 0.9mm tall. Very tall. Much taller than the 3D model
    previously indicated.
2019-03-22 pcb: led: swap pins 1 and 2 of the RGB LED
    These pins were incorrectly swapped. In practice, this wasn't an issue,
    because pin 4 is the key and that was correct. We just had incorrect
    color mappings.
2019-03-22 pcb: sch: correct pin A5 -> 3.3V (and RGB LED pinout)
    Correct pin A5, which previously was getting sent to GND, but actually
    should be routed to 3.3V.
    [tomu-fpga.sch]
2019-03-22 pcb: correct RGB LED pinout, route A5 -> 3.3V
    Route pin A5 to 3.3V instead of GND. As part of the schematic change,
    two capacitors needed to be rotated, though this shouldn't affect
    anything electrically.
    Also update the pinout for the RGB LED, but don't change the gerber
    traces at all.
    Practically, the only change is on layer 3 where a 3.3V pour has been
    extended so that it is hit by pin A5.
    [tomu-fpga.kicad_pcb]
2019-03-22 releases: dvt2a: add initial gerbers
    Add the initial documents such as gerbers and netlist files.
    This is still missing the assembly diagrams as well as the BOM.
    [tomu-fpga-B.CrtYd.gbr, tomu-fpga-B.Cu.gbl, tomu-fpga-B.Fab.gbr, tomu-fpga-B.Mask.gbs, tomu-fpga-B.Paste.gbp, tomu-fpga-Edge.Cuts.gm1, tomu-fpga-F.CrtYd.gbr, tomu-fpga-F.Cu.gtl]
2019-03-22 kicad_pcb: change output directory (and redo timestamps)
    Change the output directory to `dvt2a`.
    Also, KiCad really likes to redo timestamps. So everything in this file
    has had its timestamp updated, and nothing else.
    [tomu-fpga.kicad_pcb]
2019-03-25 commit changes made by kicad
    It's not clear why it creates these "rescue" libraries and then starts
    referring to them instead of the original library, but I'll commit them
    so that other users can open the file.
    [tomu-fpga.kicad_pcb, tomu-fpga.sch]
2019-03-25 reference: add dvt2a schematic
2019-03-25 releases: add schematic to dvt2a
2019-03-25 rescue: remove that file and remove "-rescue" suffix
    It's still not clear why it needs to do this every time. Kicad quirk,
    I guess.
    [tomu-fpga.sch]
2019-03-25 releases: add bom and assembly diagram for dvt2
    [tomu-fpga-bom.csv]
2019-04-09 pcb: make changes for pvt
    This makes some changes as requested by the new PCB factory. It moves
    some traces around, and adjusts the RGB LED slightly.
    [tomu-fpga.kicad_pcb]
2019-04-09 pcb: generate release for pvt1
    [tomu-fpga.kicad_pcb]
2019-04-09 sch: update schematic annotations
    [tomu-fpga.sch]
2019-04-09 pcb: update pcb annotations
    [tomu-fpga.kicad_pcb]
2019-04-09 pvt1: release pvt1
    [tomu-fpga-B.Cu.gbl, tomu-fpga-B.Mask.gbs, tomu-fpga-B.Paste.gbp, tomu-fpga-Edge.Cuts.gm1, tomu-fpga-F.Cu.gtl, tomu-fpga-F.Mask.gts, tomu-fpga-F.Paste.gtp, tomu-fpga-NPTH-drl_map.gbr]
2019-04-09 pvt1: add eco1.user comments file
    [tomu-fpga-B.Cu.gbl, tomu-fpga-B.Mask.gbs, tomu-fpga-B.Paste.gbp, tomu-fpga-Eco1.User.gbr, tomu-fpga-Edge.Cuts.gm1, tomu-fpga-F.Cu.gtl, tomu-fpga-F.Mask.gts, tomu-fpga-F.Paste.gtp]
2019-04-10 case: add v0.1 of case
    This is based on the Tomu case, with gaps for Fomu's hardware.
    [case_0.1.FCStd]
2019-04-11 case: add v0.2 of case (and stl files)
    [case_0.1.stl, case_0.2.FCStd, case_0.2.stl]
2019-04-18 case: release production version
    [case_0.2.FCStd, case_0.3.FCStd, case_0.3.stl, case_0.4.FCStd, case_0.4.stl, case_0.5.FCStd, case_0.5.stl, case_0.6.FCStd]
2019-05-13 prod: add BOM for dvt/pvt
2019-05-21 sch: give part number for SPI Flash as Value
    Rather than just having the part number in the "MPN" field, tack it on
    to the "Value" field as well so that it shows up in the plotted
    schematic.
    [tomu-fpga.sch]
2019-05-21 reference: re-plot evt3 schematic
2019-07-06 Rework directory structure of dvt board.
    [tomu-fpga-B.CrtYd.gbr, tomu-fpga-B.Cu.gbl, tomu-fpga-B.Fab.gbr, tomu-fpga-B.Mask.gbs, tomu-fpga-B.Paste.gbp, tomu-fpga-B.SilkS.gbo, tomu-fpga-Cmts.User.gbr, tomu-fpga-Edge.Cuts.gm1]
2019-07-06 Rework the dvt reference directory.
    [tomu-fpga-B.CrtYd.gbr, tomu-fpga-B.Cu.gbl, tomu-fpga-B.Fab.gbr, tomu-fpga-B.Mask.gbs, tomu-fpga-B.Paste.gbp, tomu-fpga-B.SilkS.gbo, tomu-fpga-Cmts.User.gbr, tomu-fpga-Edge.Cuts.gm1]
2019-07-06 Move dvt reference pdfs into the archive/dvt directory.
    [FPGA-iCE40UP 5k Pinout.xlsx]
2019-07-06 Move evt into archive evt directory.
    [tomu-fpga.kicad_pcb, tomu-fpga.sch]
2019-07-06 Move evt releases under archive/evt/releases
    [tomu-fpga-B.Cu.gbl, tomu-fpga-B.Mask.gbs, tomu-fpga-B.Paste.gbp, tomu-fpga-B.SilkS.gbo, tomu-fpga-Cmts.User.gbr, tomu-fpga-Edge.Cuts.gm1, tomu-fpga-F.Cu.gtl, tomu-fpga-F.Mask.gts]
2019-07-06 Move the gerbers under the gerber directory.
    [tomu-fpga-B.Cu.gbl, tomu-fpga-B.Mask.gbs, tomu-fpga-B.Paste.gbp, tomu-fpga-B.SilkS.gbo, tomu-fpga-Cmts.User.gbr, tomu-fpga-Edge.Cuts.gm1, tomu-fpga-F.Cu.gtl, tomu-fpga-F.Mask.gts]
2019-07-06 Move the evt reference PDFs under the evt directory.
    [FPGA-iCE40UP 5k Pinout.xlsx]
2019-07-06 Reorganize the pvt tag branch.
    [FPGA-iCE40UP 5k Pinout.xlsx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]
2019-07-06 Move case directory.
    [case_0.1.FCStd, case_0.1.stl, case_0.2.FCStd, case_0.2.stl, case_0.3.FCStd, case_0.3.stl, case_0.4.FCStd, case_0.4.stl]
2019-07-06 Remove ancient pcb image.
2019-09-04 Fix: resolve kicad project file merge conflicts
2019-10-07 add .pdf of PVT1 schematic
2020-01-07 Adding images of pvt board
2021-11-12 Add fomu pvt test point image
    Based off the kicad test point labeling.
2021-11-24 Add 3D shape file for pvt programming jig
    Includes the freecad design as well as a basic parts list for building a
    jig that matches the pin out for the pvt fomu. Also includes images
    showing the assembled jig.
    [fomu-pvt-jig.FCStd]
2022-09-08 pvt: put correct flash description in BOM
    The flash part is a 2BM (16 Mbit) USON-8, not a 128 Mbit SOIC-8.
